andrewparlane/fiuba6661_microelectronica_tpfinal/informe/6661_andrewp_TP_Final_v1_comentarios_mariano.pdf

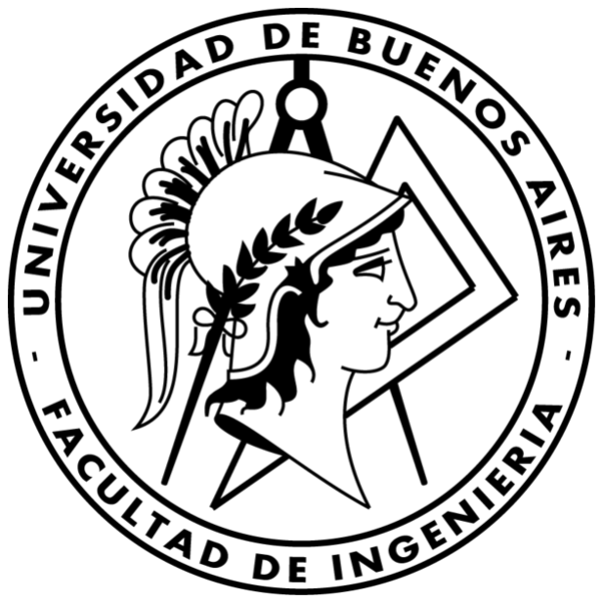
[picture p29: figure]

### 66.61 - Tecnología de Circuitos Integrados Trabajo Práctico Final Sintetizador de Frecuencias para un Microcontrolador con un PLL Digital

### Andrew Parlane

### 30 de marzo de 2019

1

Comentarios generales:
- mover las figuras cerca del lugar del texto dónde son mencionadas (es muy incómodo tener que adelantar páginas para ver las figuras)
- corregir los errores del texto
- Agregar las secciones de introducción y conclusiones

## Índice

1. Objetivo | 3
2. TSMC 180 | 3
3. Compuertas básicos | 3
4. VCO | 4
5. Divisor de Frecuencias | 7
6. PFD y el Filtro de Lazo | 10
7. PLLD y Sintetizador de Frecuencias | 11

## Índice de figuras

1. | Esquemático de dos inversores cascadas | | 3
2. | Simulación para encontrar el mejor ratio entre WN Y WP | | 4
3. | Una selección de compuertas | | 5
4. | Un Oscilador en Anillo limitado por corriente | | 5
5. | Fuente de corriente controlado por tensión | | 6
6. | Simulación de la fuente de corriente controlado por tensión | | 6
7. | Esquemático del VCO | | 7
8. | Esquemático de la prueba para VCO | | 7
9. | Simulación de Frecuencia medida y estimada contra WN | | 8
10. Simulación de Frecuencia medida y estimada contra VIN | | 8
11. Implementación de un divisor de frecuencias de 2N | | | 9
12. Prueba para el divisor de frecuencias de 2N | | 9
13. Divisor de frecuencias de 2N | | 9
14. Divisor de frecuencias de 2N con otro comparrador | | 10
15. Comparación entre los dos divisores de 2N | | 10
16. Un PFD básico | | 11
17. Simulación del PFD básico | | 11
18. Otro diseño de un PFD | | 12
19. Simulación del otro PFD | | 12
20. Salida de tri-state | | 13
21. Filtro de Lazo para usar con el PFD con salida tri-state | | 13
22. Esquemático del PLLD entero | | 14
23. Simulación de un PLLD con reloj de entrada de 25 MHz y salida 200 MHz | | 15
24. Simulación de un PLLD con reloj de entrada de 12 MHz y salida 264 MHz | | 15
25. Simulación de un PLLD con reloj de entrada de 100 MHz y salida 200 MHz. . . . | 16
26. Simulación de un PLLD con reloj de entrada de 5 MHz y salida 150 MHz | | 16
27. Esquemático de un sintetizador de frecuencias | | 16
28. Simulación de un sintetizador de frecuencias con reloj de entrada de 100 MHz y
salida 150 MHz | 17

2

## 1. Objetivo

El objetivo de este trabajo es diseñar un sintetizador de frecuencias para uso en un microcontrolador con un PLL digital. Debería tomar un reloj de entrada con frecuencia fref y unas señales de control y producir un reloj de salida con frecuencia fo = Nfref /M, donde N y M depende en las señales de control.

## 2. TSMC 180

Para comenzar tuve que aprender un poco sobre la tecnologia de TSMC 180. Leyendo los documentos dados encontré:
Parámetro | Valor
LM IN | 0.18 µm
WM IN | 0.42 µm
LDM IN | 0.48 µm
VDDMAX | 1.8 V
No pude encontrar una lista de capacitancias entre cada capa, pero en el spice.lib encontré tOX = 4.1 nm, con esto pude calcular COX = 8418 aF/µm².
Realicé una simulación para encontrar el mejor ratio entre WN y WP . Figura 1 muestra el esquemático y Figura 2 muestra el resultado. El mejor tiempo de propagación es dado cuando WP = 1,5WN . Así en este proyecto uso WPFACT = 1.5.

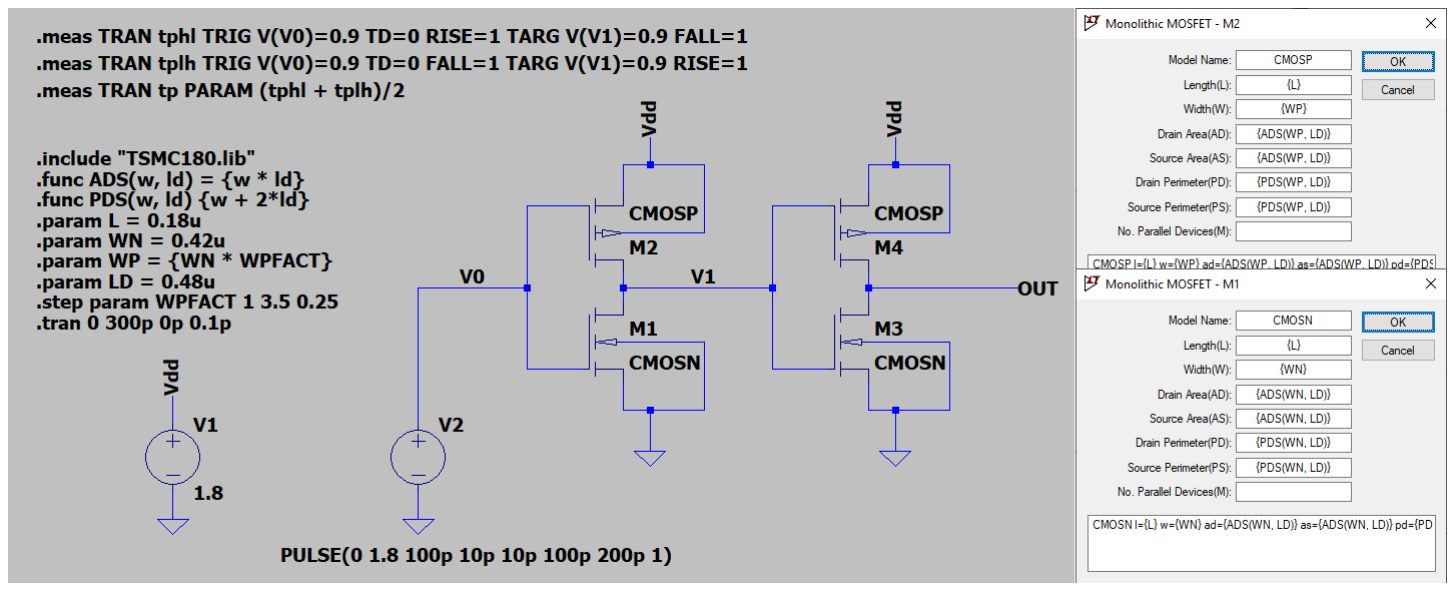
[picture p30: figure]

Figura 1: Esquemático de dos inversores cascadas.

## 3. Compuertas básicos

Implementé varias compuertas básicos y realicé simulaciones para verificar su comportamien-to. Los componentes que diseñe son:

AND con 2, 3 y 4 entradas.
FFD con reset asincróno.
Inversor con el drain conectado a VDD y el source conectado a tierra. Inversor con el drain y el source exportado en el netlist.
MUX con 2 vias.
MUX con 4 vias y salida invertido.
NAND con 2, 3 y 4 entradas.

3

Agregar una sección de "Introducción" al PLL propuesto con un diagrama en bloques y una explicación general de su funcionamiento y las señales involucradas.

en --

a

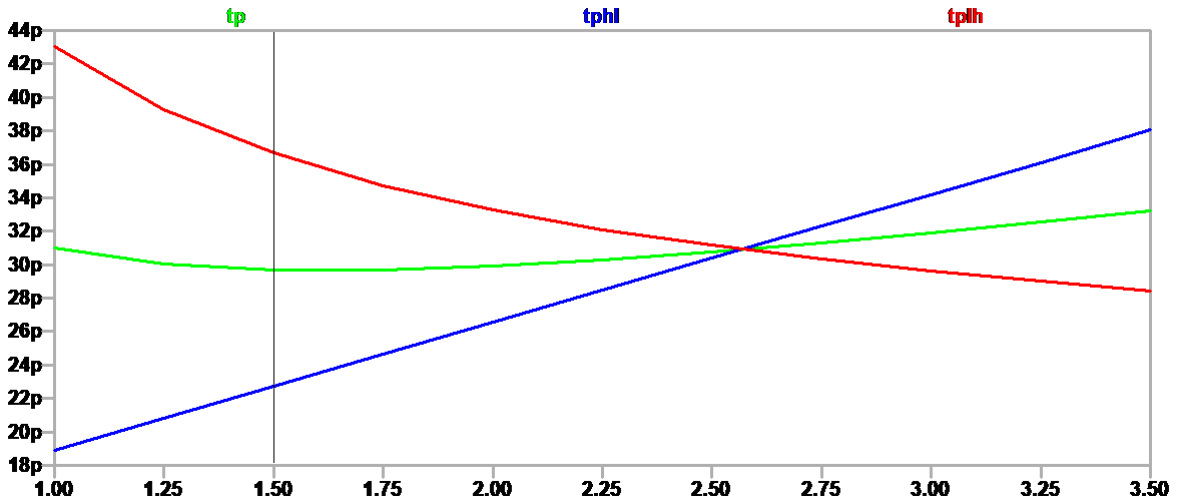
[picture p31: figure]

Figura 2: Simulación para encontrar el mejor ratio entre WN Y WP

NOR con 2 entradas.
OR con 2 entradas.
Transmission Gate.
XNOR con 2 entradas.
XOR con 2 entradas.

No he usado todos en mi diseño final. Cada compuerta consiste de un .asc y un .asy, y es parametrizado así que cada instancia puede usar tamaños diferentes. Figura 3 muestra una selección de las compuertas.

## 4. VCO

Hay varias formas construir un VCO (por Voltage Controlled Oscillator), elegí usar un oscilador en anillo limitado por corriente. Figura 4 muestra la idea. Funciona cómo un oscilador en anillo normal pero los fuentes de corrientes controlan el tiempo de propagación del inversor, cambiando la frecuencia de operación:

Ctot = 5
2

COX(WN LN + WP LP )

f = ID NCtotVDD

Donde N es el número de inversores en el anillo, y WN , LN , WP , LP son los anchos y largos de los transistores en los inversores. Elegí una corriente central de 10 µA que me da por inversores mínimos, y N = 7:

| Ctot = 4.0 fF f = 198.4 MHz

El primer parte estuvo diseñar una fuente de corriente controlado por tensión. Figura 5 muestra el diseño que usé.

4

Dejar en la lista solo las que se hayan usado en este proyecto.

consistió en | La

------------ utilizado.

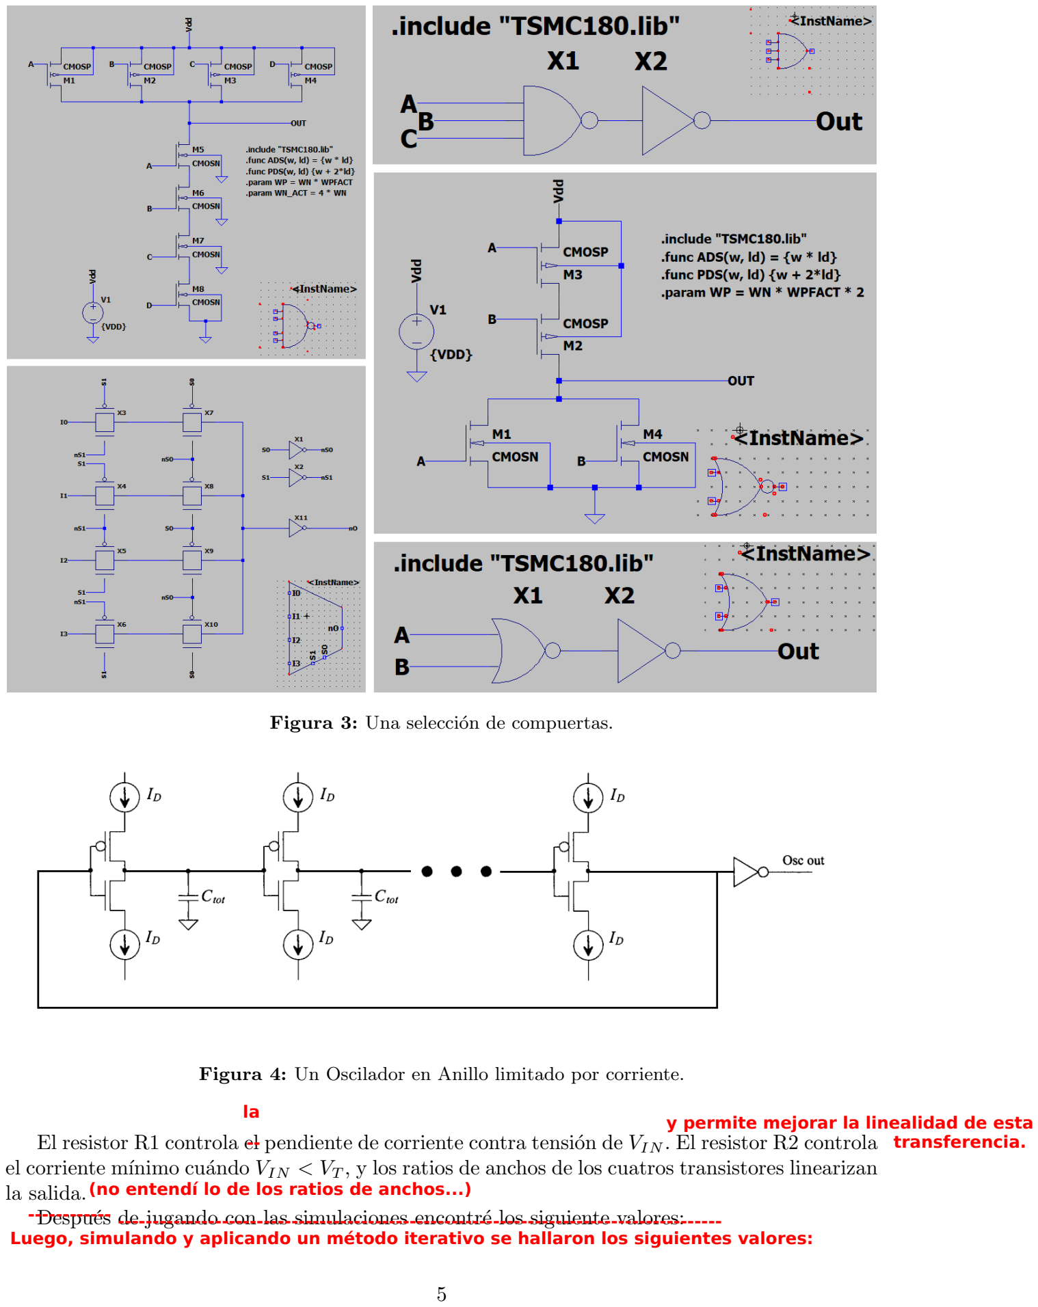
[picture p32: page 5]

Figura 3: Una selección de compuertas.

Figura 4: Un Oscilador en Anillo limitado por corriente.

El resistor R1 controla el pendiente de corriente contra tensión de VIN . El resistor R2 controla el corriente mínimo cuándo VIN < VT , y los ratios de anchos de los cuatros transistores linearizan la salida.
Después de jugando con las simulaciones encontré los siguiente valores:

5

la | y permite mejorar la linealidad de esta transferencia.

(no entendí lo de los ratios de anchos...) --------------------------------------------------------------------------------------- ------------
Luego, simulando y aplicando un método iterativo se hallaron los siguientes valores:


Figura 5: Fuente de corriente controlado por tensión.

L = 0.9 µm
WN = 4.0 µm
W P F ACT = 1,5
W IDEF ACT = 3
R1 = 20.0 kΩ
R2 = 86.0 kΩ

Que me da la salida mostrado en figura 6. Un corriente mínimo de 5.0 µA, un corriente central de 9.9 µA, y un corriente máximo de 20.4 µA. El pendiente es bastante lineal por VIN > 0.7 V, cómo mostrado con la línea azul, con una ecuación de ID = 11.5 µA/VVIN − 0.5 µA.

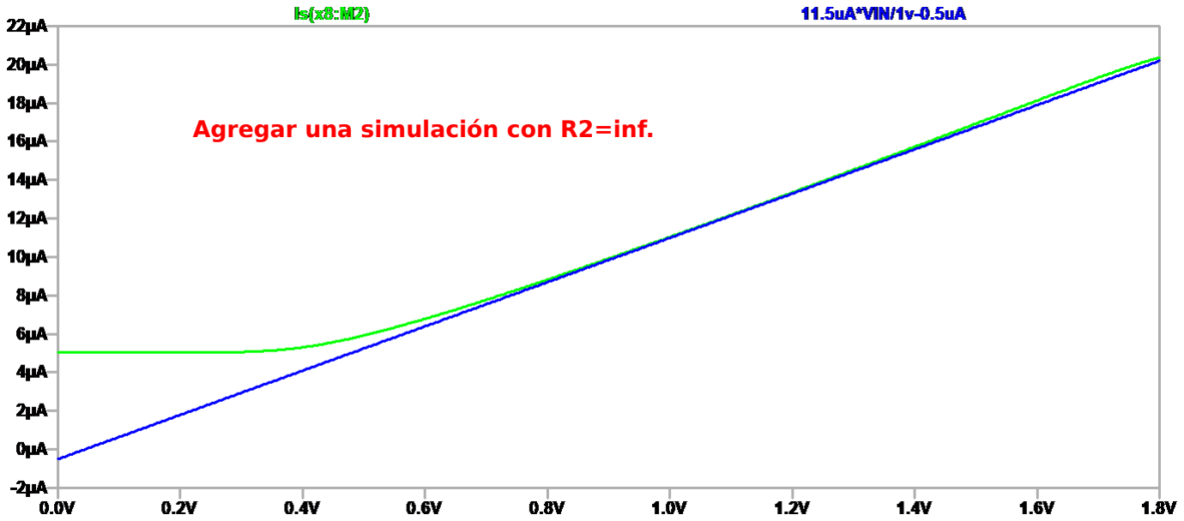
[picture p33: figure]
Agregar una simulación con R2=inf.

Figura 6: Simulación de la fuente de corriente controlado por tensión.

Figura 7 muestra el esquemático del VCO, y Figura 8 muestra el esquemático de prueba con todos los parámetros. Uso directivos de SPICE para medir y calcular la frecuencia promedio y el

6

Dar los W de cada transistor

a | a | a
para LA | ----------- aproximadamente

duty cycle sobre 100 ciclos. También calculo la frecuencia de salida esperado usando las ecuaciones anteriores. Encontré que la práctica y la teoría están bastante diferentes para inversores mínimos, así realicé otras simulaciones para ver cómo cambiando WN afecta estos valores. Figura 9 muestra el resultado. La frecuencia calculada y medida están iguales por WN = 0.52 µm y VIN = 0.9 V. Intenté usar este valor pero la simulación estuvo dando me resultados raros por VIN < 0.5 V, así estoy usando WN = 0.57 µm.

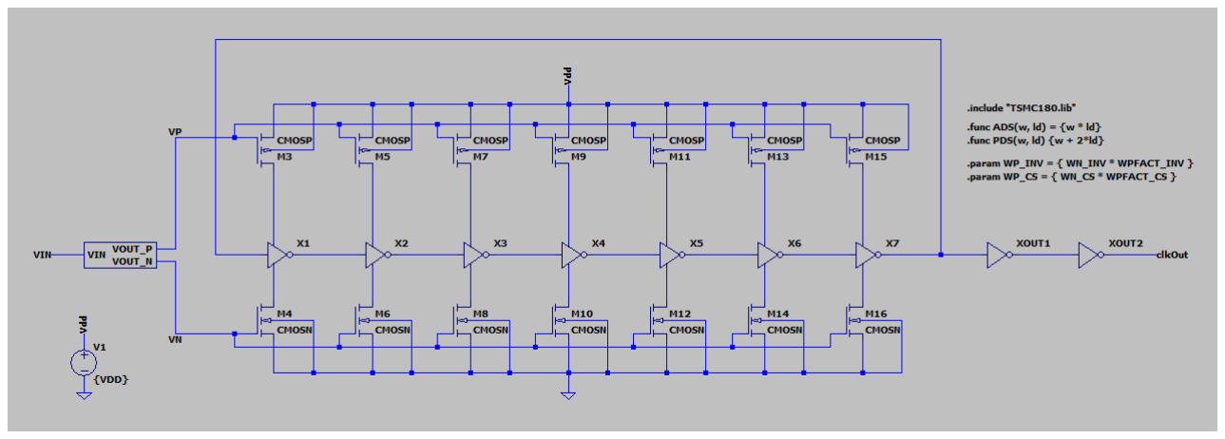
[picture p34: figure]

Figura 7: Esquemático del VCO.

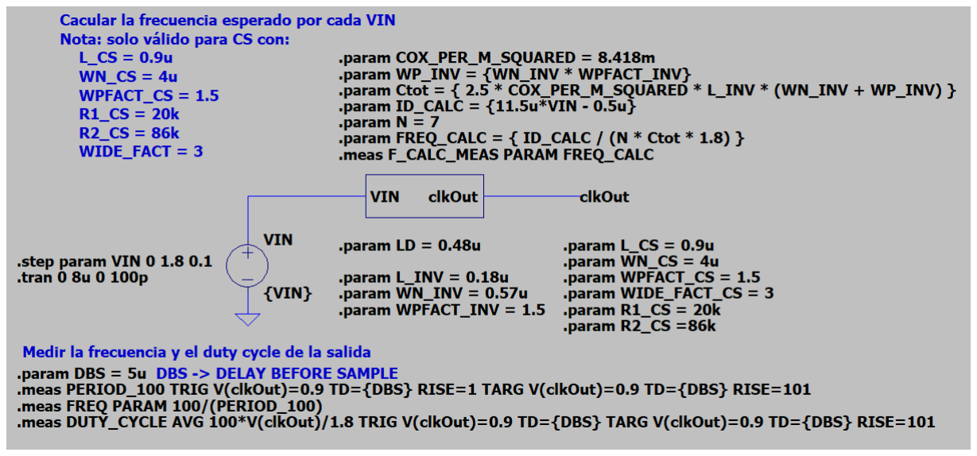
[picture p35: figure]

Figura 8: Esquemático de la prueba para VCO.

Figura 10 muestra cómo cambia la frecuencia medido y estimado con VIN . No están iguales pero están bastante cerca. El pendiente del parte lineal es aproximadamente 200 MHz/V dando un KV CO = 2π · 200 MHz/V = 1.26 × 10⁹ rad/(V s).

## 5. Divisor de Frecuencias

Hay varias arquitecturas para implementar divisores de frecuencias, cual es mejor depende en la especificación del proyecto. Para este trabajo quise dividir por un valor programable.
Al principio implemente un divisor de frecuencias que puede dividir por 2N . La implementación es N FFDs en cascada cómo muestra Figura 11. Cada ciclo del clkIn hace que div2 invierte

7

a
------- son

(no entendí la última oración)

simulada ------------

la calculada ---------------------

------------------------------------ LA Se observa que ambas curvas son similares para Vin entre ...V y ...V.

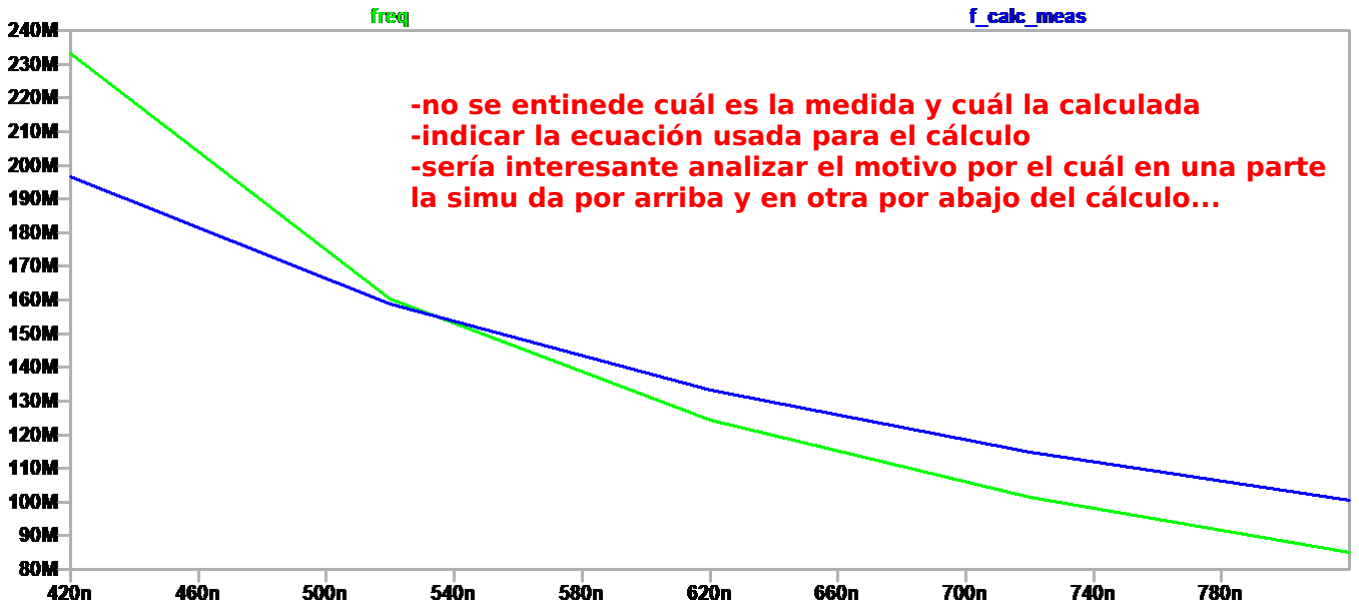
[picture p36: figure]

Figura 9: Simulación de Frecuencia medida y estimada contra WN .

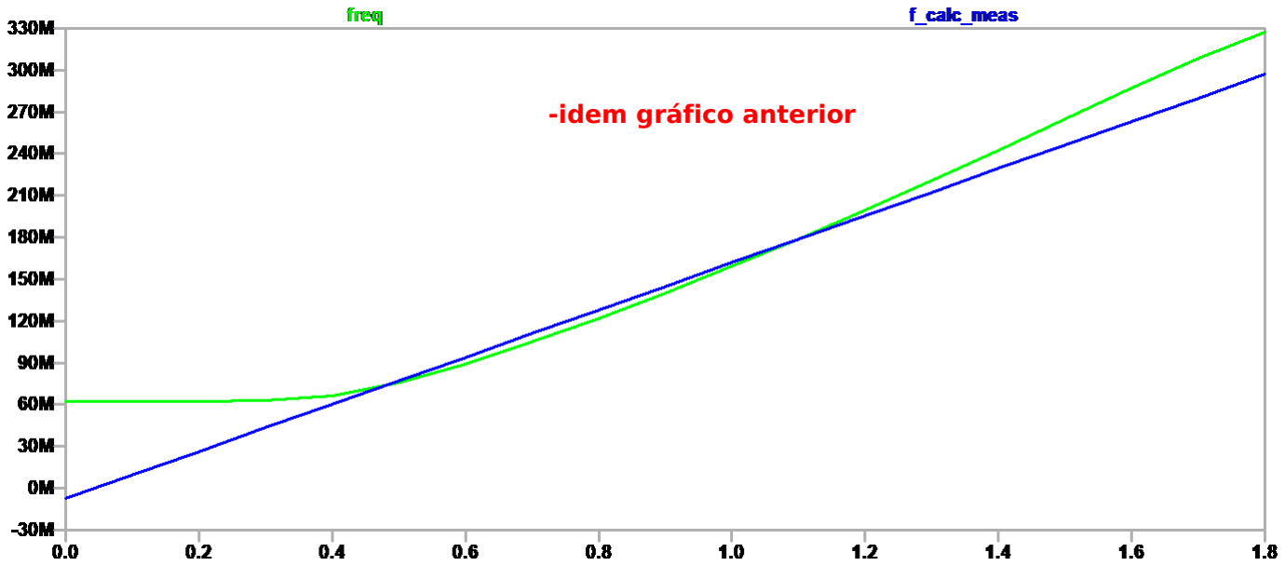
[picture p37: figure]
-idem gráfico anterior

Figura 10: Simulación de Frecuencia medida y estimada contra VIN .

su valor, así div2 completa un ciclo cada dos ciclos de/ clkIn. Después div4 completa un ciclo cada dos ciclos de/ div2, o cuatro ciclos del clkIn, etc... Mi implementación solo permite dividir hasta 16, para dividir por factores más altos puede conectar dos de los componentes en cascada. Un MUX puede ser usado para elegir la salida querido, como muestra Figura 12.
El problema con esta arquitectura es que cuando está usado en el PLLD, solo se permite obtener uno o dos frecuencias válidos. Por ejemplo con el VCO descripto en la sección anterior, la salida del VCO tiene que ser entre 60 MHz y 330 MHz. Por un reloj de entrada de 12 MHz solo podríamos usar un divisor de 8 para obtener 96 MHz o de 16 para obtener 192 MHz. Un divisor de 4 da una salida de 48 MHz y un divisor de 32 da una salida de 384 MHz, ambos de los dos están afuera del rango de la operación del VCO.
Un divisor que puede producir un rango lineal de salidas nos da más opciones. Así implementé un componente que divide por 2N. Figura 13 muestra una implementación. De nuevo usa una cadena de FFDs, pero este vez se usa como un contador digital. Unas compuertas XNOR hacen

8

-no se entinede cuál es la medida y cuál la calculada -indicar la ecuación usada para el cálculo
-sería interesante analizar el motivo por el cuál en una parte la simu da por arriba y en otra por abajo del cálculo...
a | a

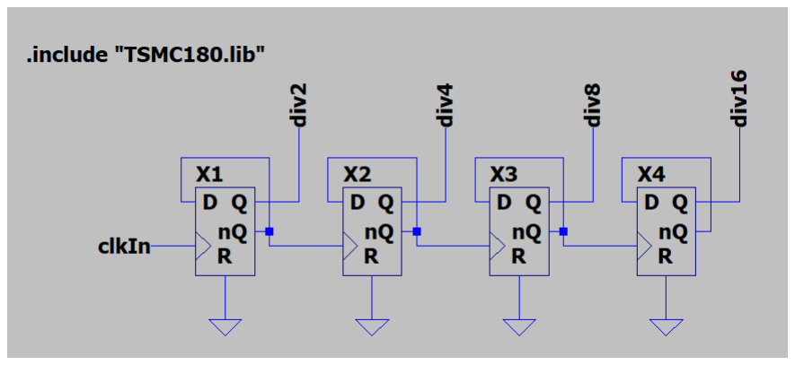
[picture p38: figure]

Figura 11: Implementación de un divisor de frecuencias de 2N

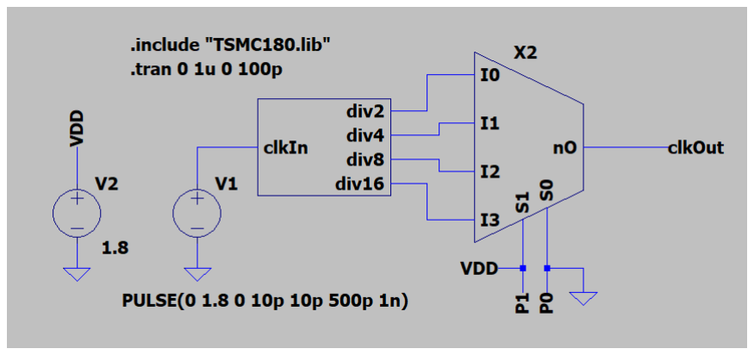
[picture p39: figure]

Figura 12: Prueba para el divisor de frecuencias de 2N

una comparación entre el valor del contador Q y el factor de división querido P. Cuando todos los bits están iguales invierte el clkOut. También implementé un otro divisor, mostrado en Figura 14, que es muy parecido. La única diferencia es el comparador. Figura 15 muestra una simulación comparando los dos. El primer diseño (con las compuertas XNOR) es aproximadamente 270 ps más rápido que el segundo, así elegí usar eso. Los dos diseños no funcionan cuando P = 0 y dan una salida con frecuencia fout = fin/2P por los demás valores de P.

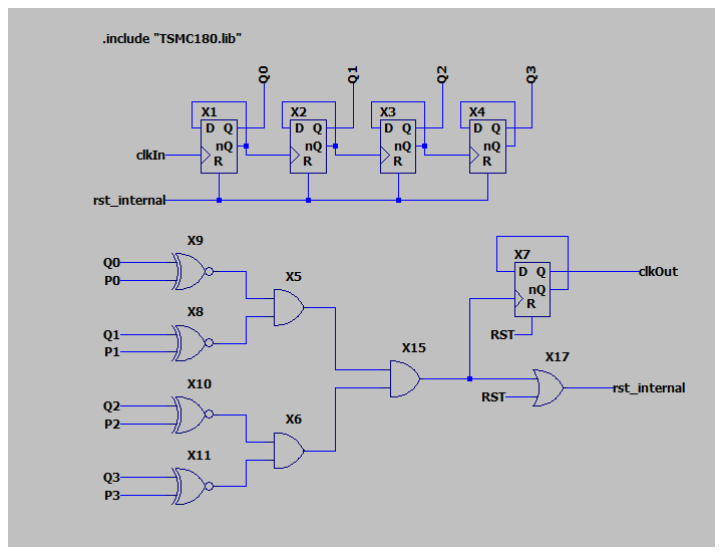
[picture p40: figure]

Figura 13: Divisor de frecuencias de 2N.

9

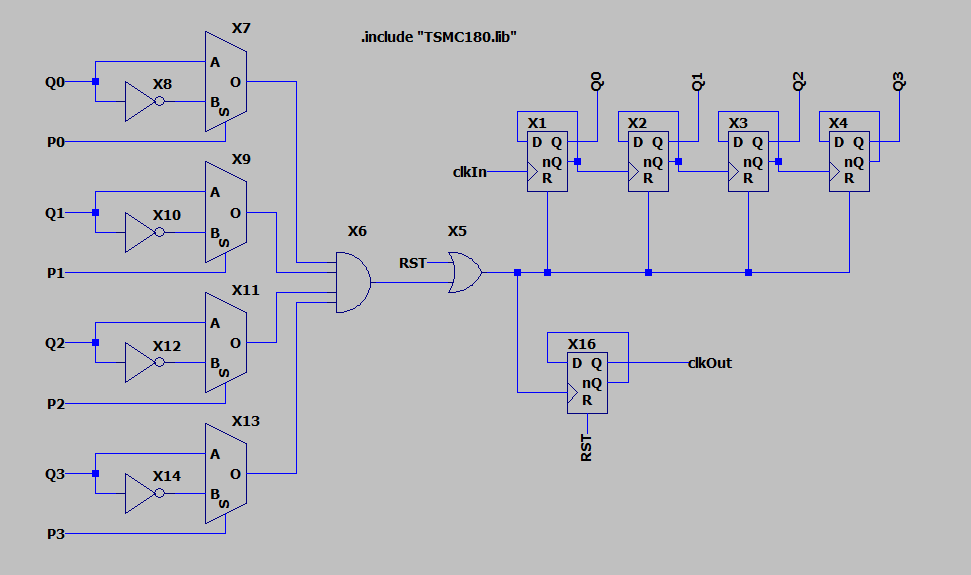
[picture p41: figure]

Figura 14: Divisor de frecuencias de 2N con otro comparrador.

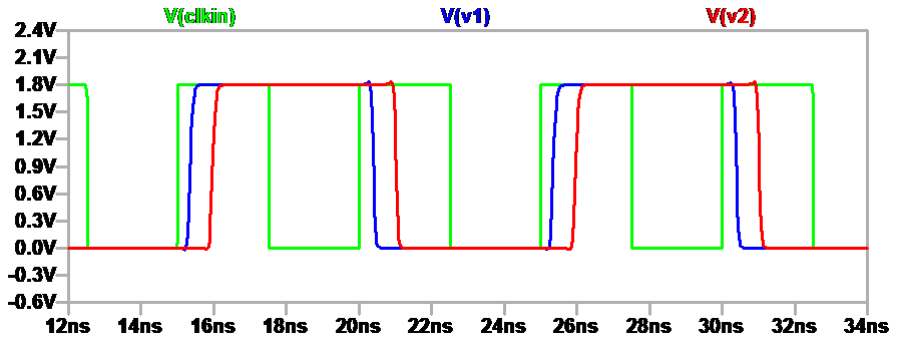
[picture p42: figure]

Figura 15: Comparación entre los dos divisores de 2N.

Con este divisor de frecuencias, el VCO de la sección anterior y un reloj de entrada de 12 MHz, podríamos producir 11 salidas con frecuencias entre 72 MHz y 312 MHz.

## 6. PFD y el Filtro de Lazo

El PFD (por Phase Frequency Detector) es un componente que toma dos señales y indique la diferencia entre sus fases. Figura 16 muestra una implementación de un PFD. En el primer flanco ascendente de dClock o clkIn la salida de su FFD cambia a un uno. Cuando llega el flanco del otro señal, la salida de su FFD cambia a un uno también, así la salida de la compuerta AND cambia a un uno y pone a cero los dos FFDs. Así la salida UP o DOWN es alto por el tiempo entre los flancos ascendentes de los relojes. Estos dos señales pueden ser combinados en uno para indicar la diferencia en fase. Usando directivos de SPICE medí el tiempo que las señales UP y DOWN estuvieron alto por cada offset entre los relojes entre −800 ps y 800 ps en intervales de 10 ps, figura 17 muestra estas mediciones.
Figura 18 muestra un otro diseño de un PFD, y Figura 19 muestra el ancho de los señales UP y DOWN. En este diseño hay un pequeño “dead zone” cuándo ninguno de los señales UP y DOWN están altos, pero en el diseño básico hay una superposición de aproximadamente 280 ps cuándo los dos señales están altos.
Para juntar UP y DOWN uso una salida de tri-state, Figura 20 muestra el esquemático. Cuando UP o DOWN están altos, la carga sobre los drains puede cargar o descargar, pero

10

e | -----ca
a | a
a | ------- simulé

------------------------ los resultados.

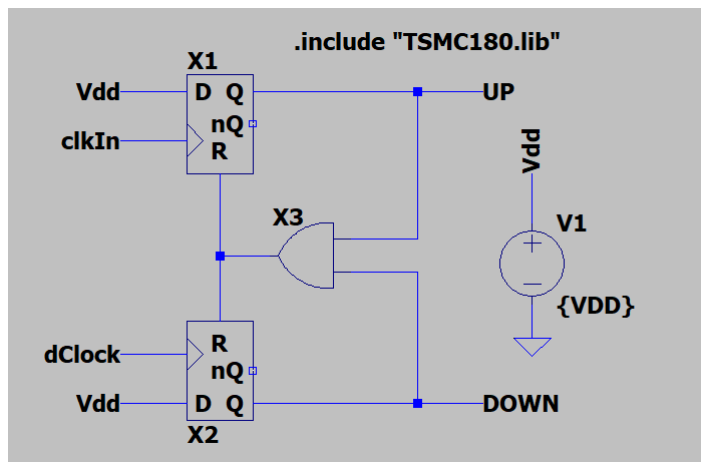
[picture p43: figure]

Figura 16: Un PFD básico.

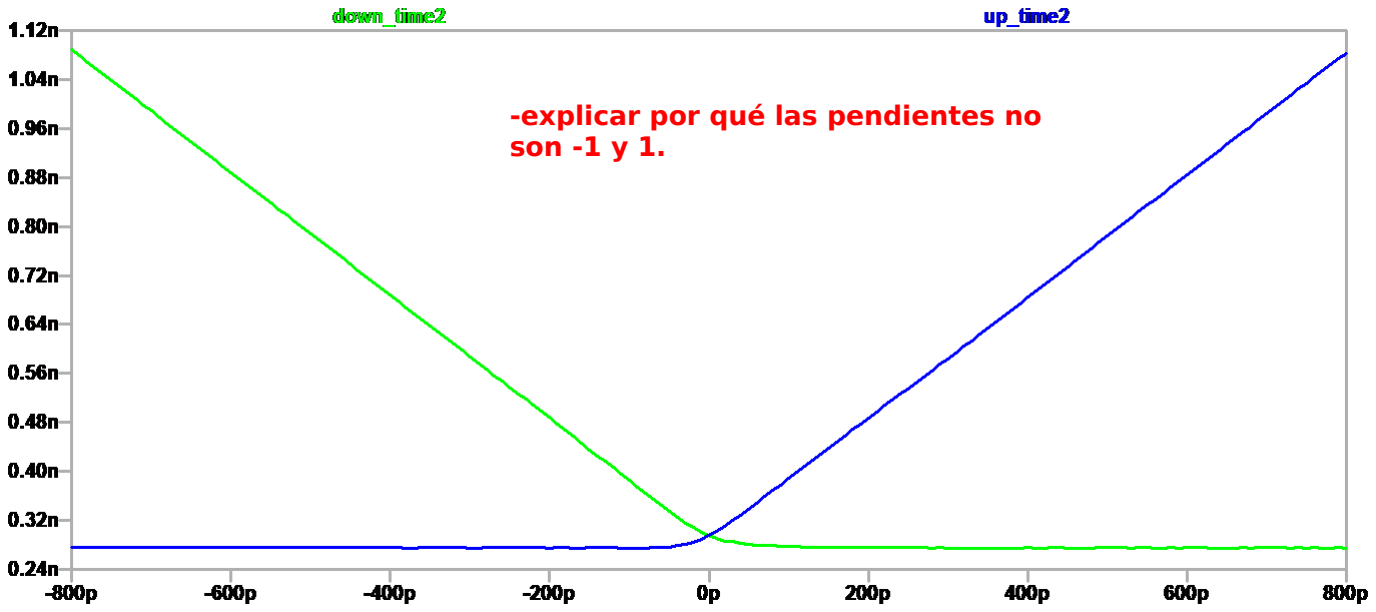
[picture p44: figure]
-explicar por qué las pendientes no son -1 y 1.

Figura 17: Simulación del PFD básico.

cuando ninguno de los señales están altos, la salida tiene alta impedancia. El gain del PFD con la salida tri-state es KPDtri = VDD/4π.
Finalmente es necesario pasar la salida del PFD por un filtro. El filtro usado es mostrado en Figura 21. La función de transferencia del filtro de lazo es: KF = 1+sR2C
s(R1+R2)C .

## 7. PLLD y Sintetizador de Frecuencias

Figura 22 muestra el esquemático final con todos los componentes conectados. Las ecuaciones para este PLL son:

11

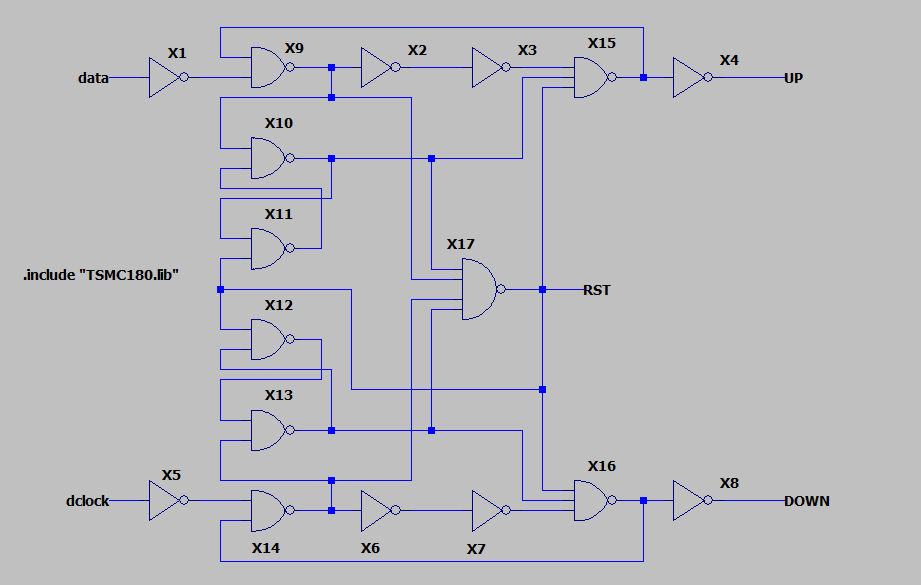
[picture p45: figure]

Figura 18: Otro diseño de un PFD.

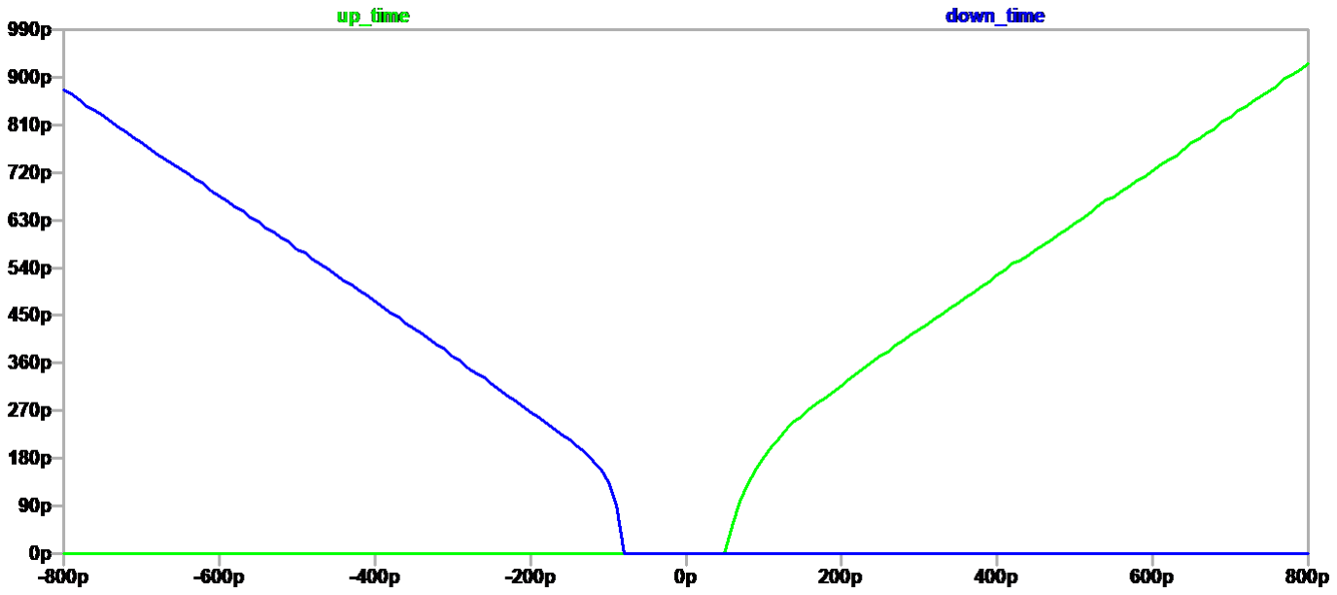
[picture p46: figure]

Figura 19: Simulación del otro PFD.

H(s) = KPDtriKF KV CO s + 1 N KPDtriKF KV CO

ωn =

| KPDtriKV CO N(R1 + R2)C
ζ = ωn | 2 R2C

ΔωL = 4πζωn
ΔωP = π
2
| 2ζωnKV COKPDtri − ω²

n

Donde:

| 12

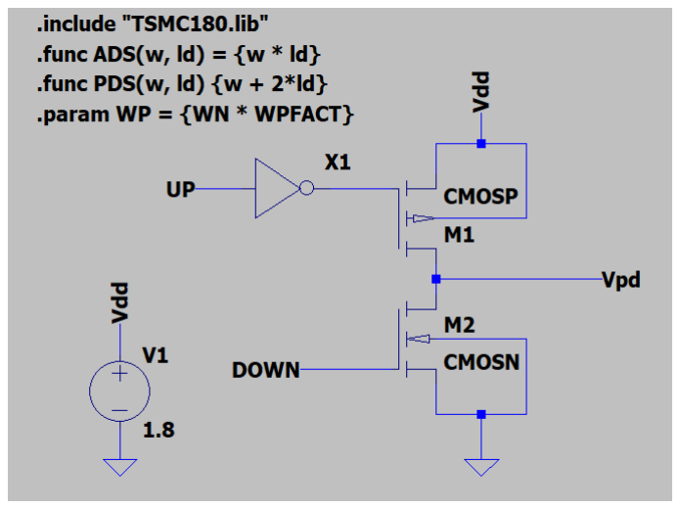
[picture p47: figure]

Figura 20: Salida de tri-state.

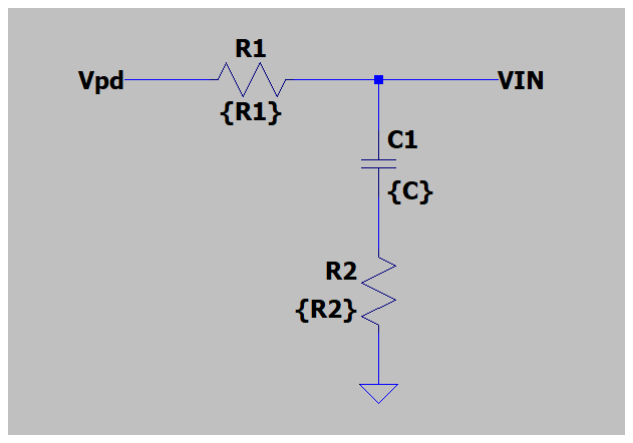
[picture p48: figure]

Figura 21: Filtro de Lazo para usar con el PFD con salida tri-state.

H(s) = La función de transferencia de fase. ωn = La frecuencia natural.
ζ = El factor de amortiguamiento.
ΔωL = El rango de lock.
N = El factor de división.
ΔωP = El rango de pull-in.

Comenzando con ζ = 1, ΔωL = 20 MHz · 2π y N = 8. Encontramos ωn = 10 × 10⁶ rad/s y R2C = 200 ns. Eligiendo C = 10 pF y R2 = 20 kΩ, podríamos encontrar R1 = 2.56 kΩ. Porque queremos tener N programable podríamos volver calcular ωn, ζ, ΔωL, y ωP por cada N entre 2 y 30.

13

Mostrar acá el circuito circuito final utilizado para el PLLD.

N | ωn (rad/s) | ζ | ωL (rad/s) | FL (MHz) | Wp (rad/s) | Fp (MHz)
2 4 6 8 10 12 14 16 18 20 22 24 26 28 30 | 20.00 × 10⁶ 14.14 × 10⁶ 11.55 × 10⁶ 10.00 × 10⁶ 8.94 × 10⁶ 8.16 × 10⁶ 7.56 × 10⁶ 7.07 × 10⁶ 6.67 × 10⁶ 6.32 × 10⁶ 6.03 × 10⁶ 5.77 × 10⁶ 5.55 × 10⁶ 5.35 × 10⁶ 5.16 × 10⁶ | 2.0 1.4 1.2 1.0 0.9 0.8 0.8 0.7 0.7 0.6 0.6 0.6 0.6 0.5 0.5 | 503 × 10⁶ 251 × 10⁶ 168 × 10⁶ 126 × 10⁶ 101 × 10⁶ 84 × 10⁶ 72 × 10⁶ 63 × 10⁶ 56 × 10⁶ 50 × 10⁶ 46 × 10⁶ 42 × 10⁶ 39 × 10⁶ 36 × 10⁶ 34 × 10⁶ | 80 40 27 20 16 13 11 10 9 8 7 7 6 6 5 | 521 × 10⁶ 401 × 10⁶ 321 × 10⁶ 270 × 10⁶ 235 × 10⁶ 209 × 10⁶ 189 × 10⁶ 173 × 10⁶ 160 × 10⁶ 149 × 10⁶ 139 × 10⁶ 131 × 10⁶ 124 × 10⁶ 118 × 10⁶ 112 × 10⁶ | 83 64 51 43 37 33 30 27 25 24 22 21 20 19 18

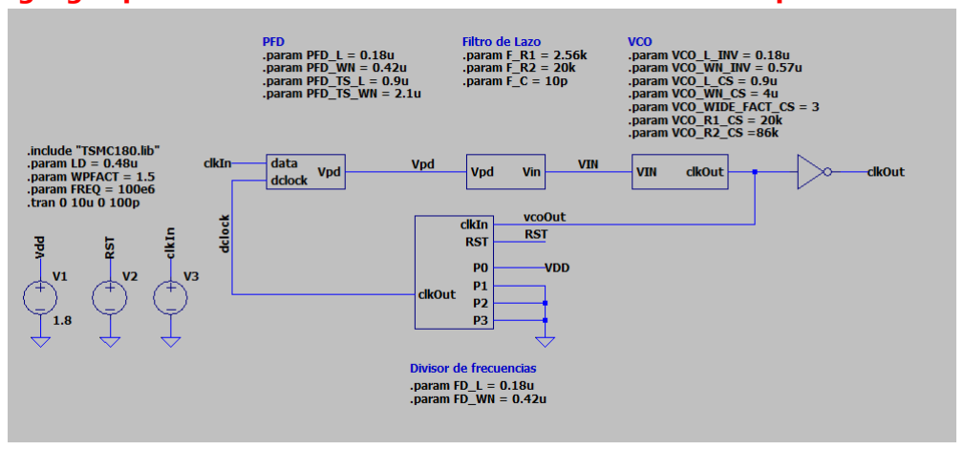
[picture p49: figure]

Figura 22: Esquemático del PLLD entero.

Figuras 23, 24, 25 y 26 muestran varias simulaciones del PLLD entero con diferentes frecuencias de entrada entre 5 MHz y 100 MHz y diferentes factores de multiplicación entre 2 y 30. Figura 27 muestra el esquemático de un sintetizador de frecuencias que connsiste en un PLLD, un prescaler y un postscaler. Figurar 28 muestra una simulación del sintetizador de frecuencias para obtener un reloj de 150 MHz desde un reloj de entrada de 100 MHz.

## Referencias

[1] R. Jacob Baker (2010) CMOS: Circuit design, layout and simulation, Wiley-IEEE Press, 3rd edition.
[2] Suman, Shruti & G Sharma, K & Ghosh, Pradip. (2016). Analysis and Design of Current Starved Ring VCO. 10.1109/ICEEOT.2016.7755299.
[3] Rushabh Mehta (2016) Ddesign and Implementation of a phase locked loop for high-speed serial links. University of Illinois. http://emlab.uiuc.edu/jose/Theses/mehta_ms.pdf.
[4] Passive Filters. http://aries.ucsd.edu/najmabadi/CLASS/ECE60L/02-S/NOTES/filter. pdf.

14

Agregar columna Fn.

Pasar referencias al final.

Agregar pie a la tabla: "Tabla 1. dinámica del sistema para diferntes valores de N".

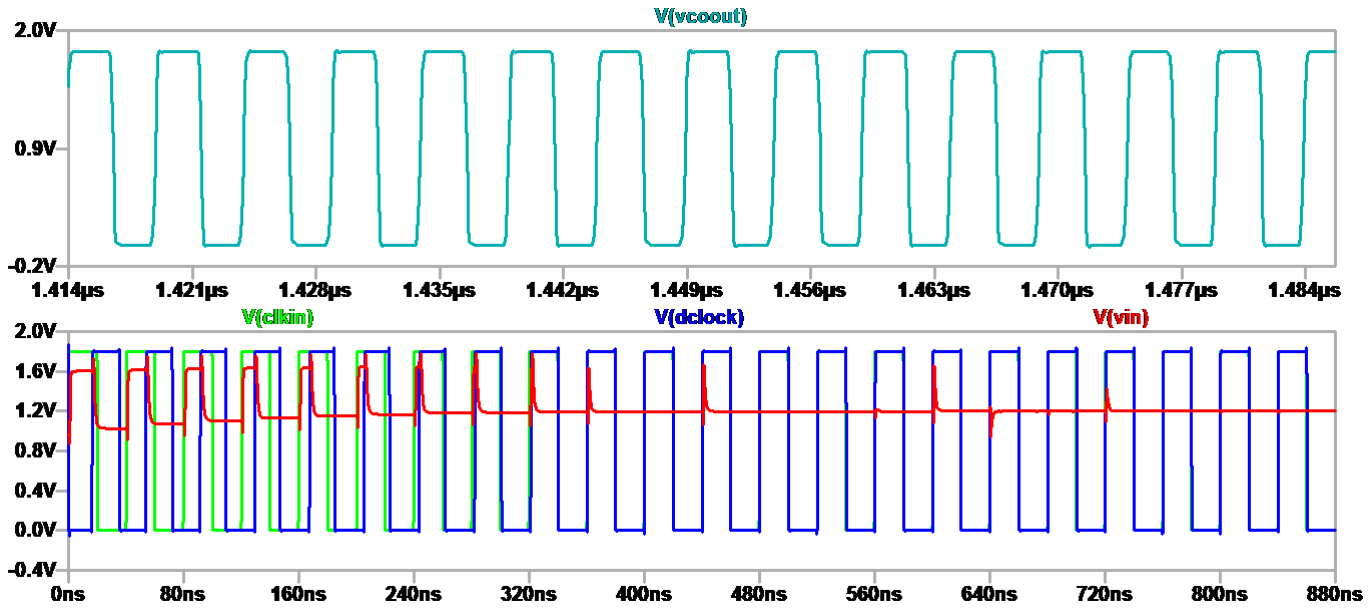
[picture p50: figure]

Figura 23: Simulación de un PLLD con reloj de entrada de 25 MHz y salida 200 MHz.

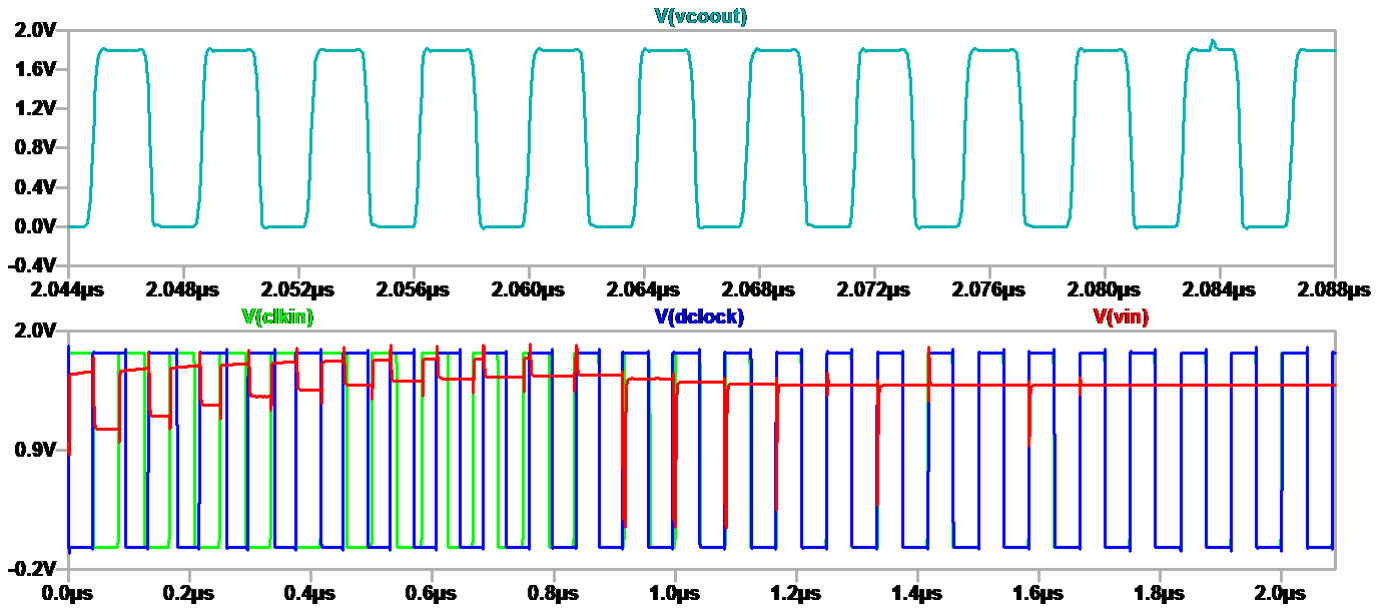
[picture p51: figure]

Figura 24: Simulación de un PLLD con reloj de entrada de 12 MHz y salida 264 MHz.

15

-Especificar para cada una de estas simulaciones el N utilizado.
-Vin es la entrada del VCO, verdad? Explicitar esto en el texto.
-Agregar un párrafo pra cada simulación describiendo el resultado obtenido y si
la dinámica del sistema es la que se espera según la Tabla 1.
-Estas simulaciones son del "encendido" del PLL, verdad? Es decir en t=0 se enciende el sistema.

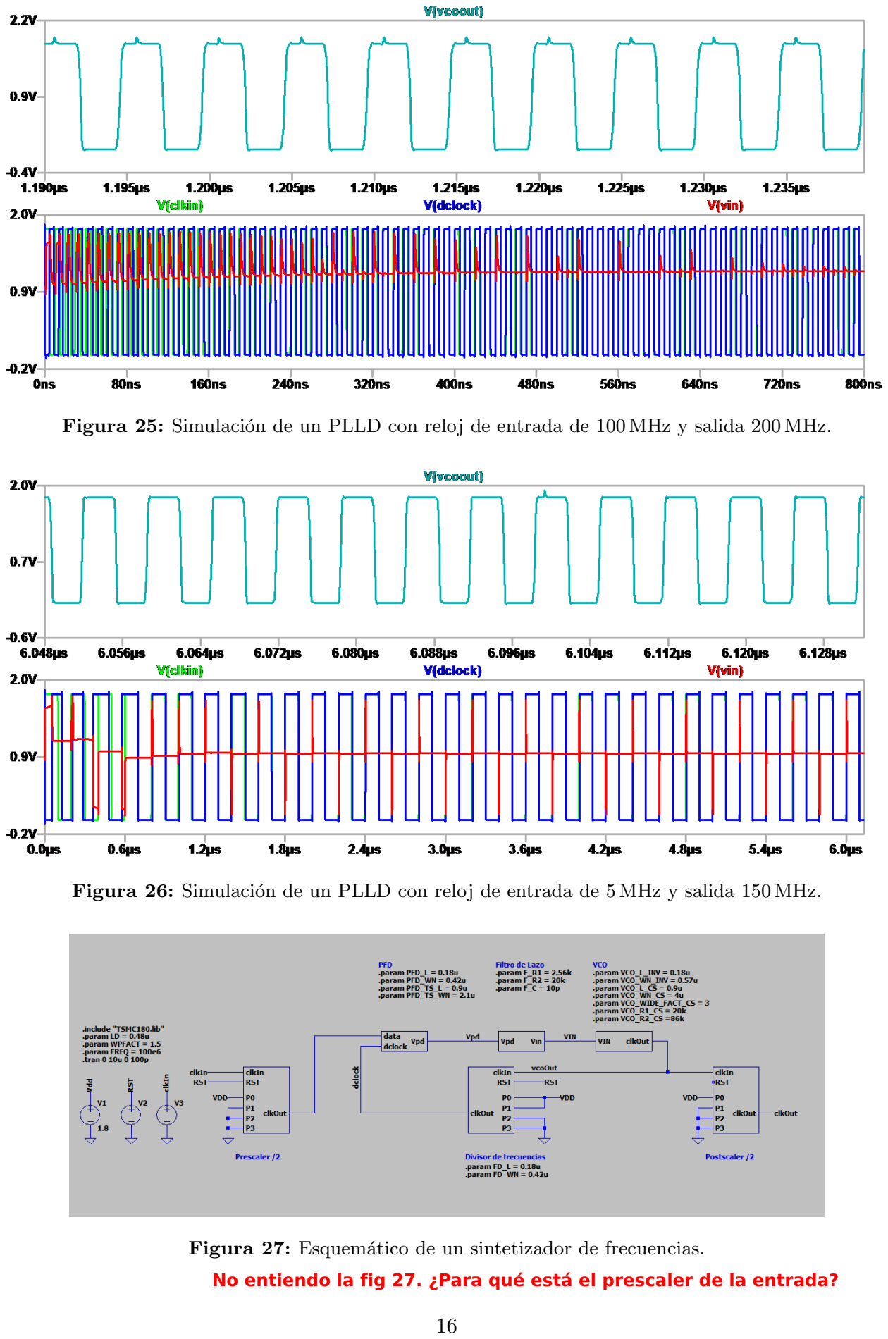
[picture p52: page 16]

Figura 25: Simulación de un PLLD con reloj de entrada de 100 MHz y salida 200 MHz.

Figura 26: Simulación de un PLLD con reloj de entrada de 5 MHz y salida 150 MHz.

Figura 27: Esquemático de un sintetizador de frecuencias.

16

No entiendo la fig 27. ¿Para qué está el prescaler de la entrada?

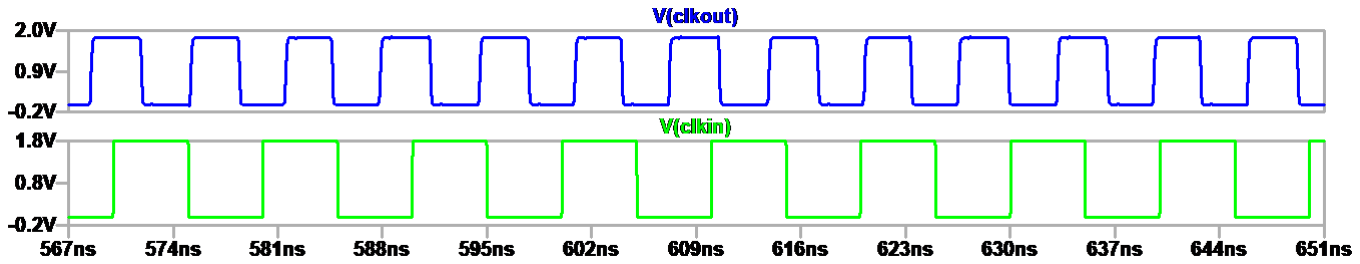
[picture p53: figure]

Figura 28: Simulación de un sintetizador de frecuencias con reloj de entrada de 100 MHz y salida 150 MHz.

17

Agregar sección "conclusiones" y discutir el desempeño obtenido.
Otras preguntas interesantes para comentar son:
-¿Vale la pena utilizar un divisor 2N o un divisor 2^N sería mejor?
-¿Sería conveniente utilizar un banco de capacitores y resistores para modificar el valor del filtro de lazo según el valor que tome N?
