andrewparlane/fiuba6661_microelectronica_tpfinal/informe/6661_andrewp_TP_Final_v2 .pdf

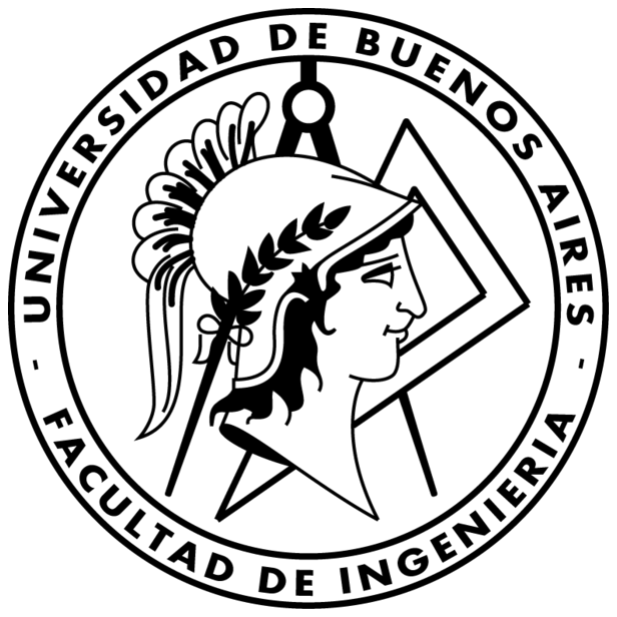
[picture p54: figure]

66.61 - Tecnología de Circuitos Integrados
Trabajo Práctico Final
Sintetizador de Frecuencias para un Microcontrolador con un PLL Digital

Andrew Parlane

4 de julio de 2019

1

## Índice

1. Objetivo | 4
2. Introducción | 4
2.1. Sintetizador de frecuencias | | 4
2.2. PLL Digital | | 4
3. TSMC 180 | 5
4. Compuertas básicos | 6
5. VCO | 7
6. Divisor de Frecuencias | 11
7. PFD y el Filtro de Lazo | 13
8. PLLD | 17
9. Sintetizador de Frecuencias | 19
10.Conclusión | 21

## Índice de figuras

1. | Un diagrama de bloques de un sintetizador de frecuencias | | 4
2. | Un diagrama de bloques de un PLLD | | 5
3. | Esquemático de dos inversores en cascada | | 6
4. | Simulación para encontrar el mejor ratio entre WN Y WP | | 6
5. | Una selección de compuertas | | 7
6. | Un Oscilador en Anillo limitado por corriente | | 7
7. | Fuente de corriente controlado por tensión | | 8
8. | Simulación de la fuente de corriente controlado por tensión | | 9
9. | Esquemático del VCO | | 9
10. Esquemático de la prueba para VCO | | 10
11. Simulación de Frecuencia medida y estimada contra WN | | 10
12. Simulación de Frecuencia medida y estimada contra VIN | | 11
13. Implementación de un divisor de frecuencias de 2N | | | 11
14. Prueba para el divisor de frecuencias de 2N | | | 12
15. Divisor de frecuencias de 2N | | 12
16. Divisor de frecuencias de 2N con otro comparrador | | 13
17. Comparación entre los dos divisores de 2N | | 13
18. Un PFD básico | | 14
19. Simulación del PFD básico | | 14
20. Otro diseño de un PFD | | 15
21. Simulación del otro PFD | | 15
22. Salida de tri-state | | 16
23. Filtro de Lazo para usar con el PFD con salida tri-state | | 16
24. Esquemático del PLLD entero | | 17

2

25. Simulación de un PLLD con reloj de entrada de 25 MHz, N=8 y salida 200 MHz. | 18
26. Simulación de un PLLD con reloj de entrada de 12 MHz, N=22 y salida 264 MHz. | 19
27. Simulación de un PLLD con reloj de entrada de 100 MHz, N=2 y salida 200 MHz. | 19
28. Simulación de un PLLD con reloj de entrada de 5 MHz, N=30 y salida 150 MHz. | 19
29. Esquemático de un sintetizador de frecuencias | | 20
30. Simulación de un sintetizador de frecuencias con reloj de entrada de 100 MHz y
salida 44.44 MHz | 20

3

## 1. Objetivo

El objetivo de este trabajo es diseñar un sintetizador de frecuencias para uso en un microcontrolador con un PLL digital. Debería tomar un reloj de entrada con frecuencia fref y unas señales de control y producir un reloj de salida con frecuencia fo = Nfref /M, donde N y M depende en las señales de control.

## 2. Introducción

### 2.1. Sintetizador de frecuencias

Un PLLD produce un reloj de salida con frecuencia fo desde un reloj de entrada con frecuencia fi con las restricciones:

fimin ≤ fi ≤ fimax

fomin ≤ fo ≤ fomax
fo = Nfi | N ∈ Z

Nmin ≤ N ≤ Nmax

Para obtener un mejor rango de fo se puede dividir la salida del PLL con un divisor de frecuencias. Frecuentemente se usa otro divisor de frecuencias antes del PLL para permitir un rango de fi más grande. Los valores de multiplicación y división pueden ser constantes o programables. Figura 1 muestra un sintetizador de frecuencias típico.

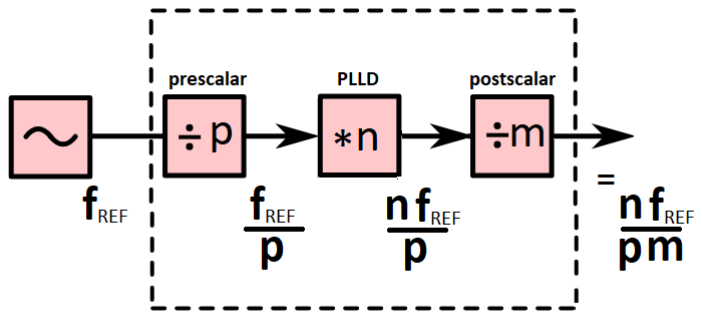
[picture p55: figure]

Figura 1: Un diagrama de bloques de un sintetizador de frecuencias

### 2.2. PLL Digital

Un PLLD consista en cuatro partes:

Un detector de fase que compara dos señales de entrada y genera una señal que representa la diferencia entre las fases.

4

Un filtro de laso que ayuda el PLL estar estable.

Un VCO (por Voltage Controlled Oscillator) que usa una tensión de entrada para cambiar la frecuencia de salida.

Un divisor de frecuencias. La señal de salida vuelva al detector de fase como una de las entradas.

En esta forma el PLL ajuste la salida hasta un múltiple de la entrada. Figura 2 muestra un PLLD en bloques.

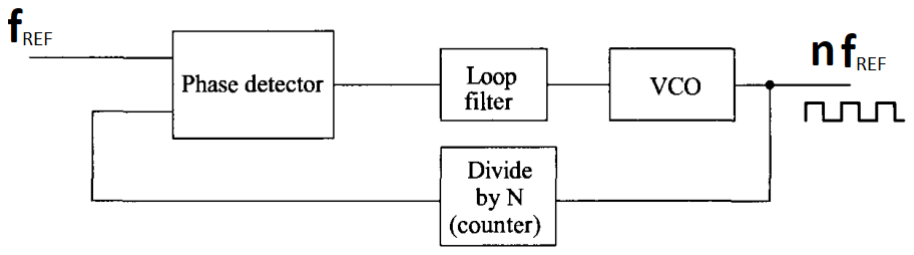
[picture p56: figure]

Figura 2: Un diagrama de bloques de un PLLD

## 3. TSMC 180

Para comenzar tuve que aprender un poco sobre la tecnologia de TSMC 180. Leyendo los documentos dados encontré:
Parámetro | Valor
LM IN | 0.18 µm
WM IN | 0.42 µm
LDM IN | 0.48 µm
VDDMAX | 1.8 V
No pude encontrar una lista de capacitancias entre cada capa, pero en el spice.lib encontré tOX = 4.1 nm, con esto pude calcular C0OX = 8418 aF/µm²
Realicé una simulación para encontrar el mejor ratio entre WN y WP . Figura 3 muestra el esquemático y Figura 4 muestra el resultado. El mejor tiempo de propagación es dado cuando WP = 1,5WN . Así en este proyecto uso W P F ACT = 1,5.

5

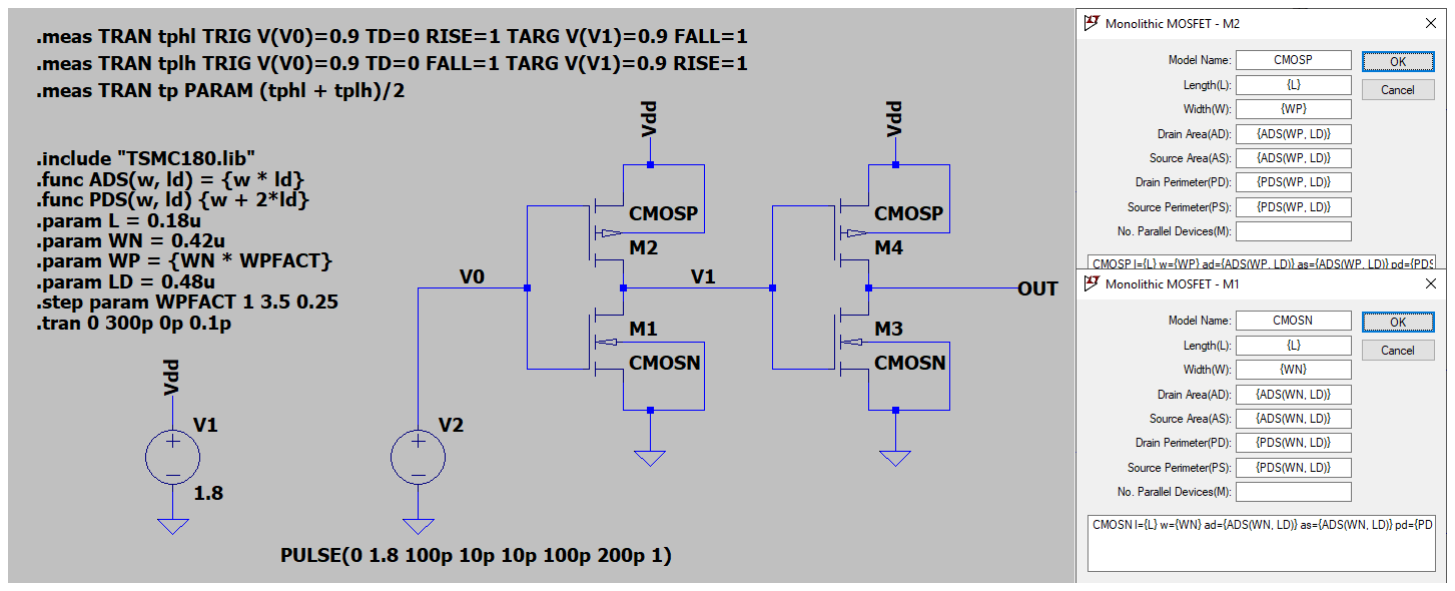
[picture p57: figure]

Figura 3: Esquemático de dos inversores en cascada

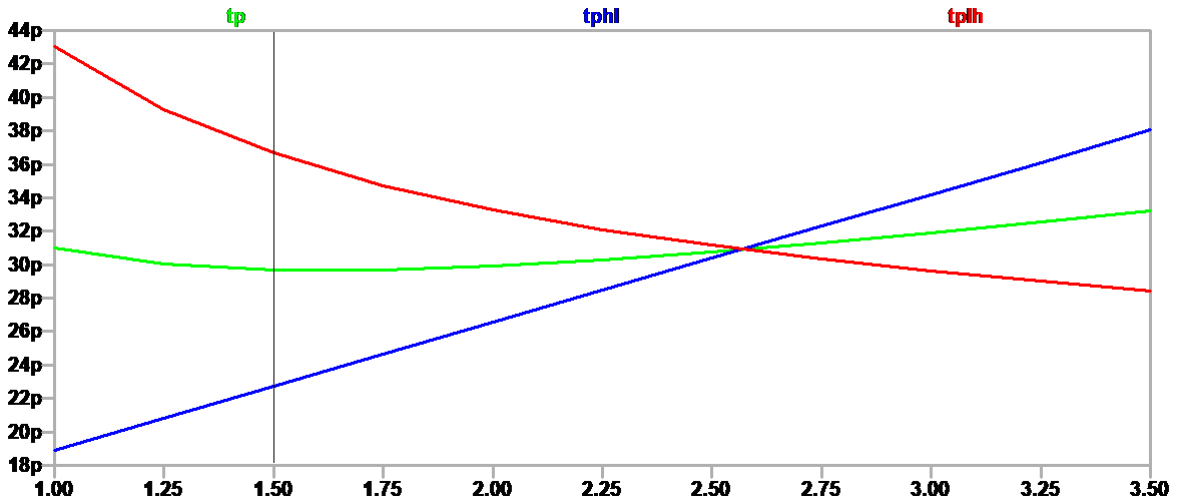
[picture p58: figure]

Figura 4: Simulación para encontrar el mejor ratio entre WN Y WP

## 4. Compuertas básicos

Implementé varias compuertas básicas y realicé simulaciones para verificar su comportamiento. Los componentes que diseñe son:

Inversor con el drain conectado a VDD y el source conectado a tierra.
Inversor con el drain y el source exportado en el netlist.
AND con 2 y 4 entradas.
NAND con 2, 3 y 4 entradas.
NOR con 2 entradas.
OR con 2 entradas.
XNOR con 2 entradas.
Transmission Gate.
MUX con 2 vias.
MUX con 4 vias y salida invertido.
FFD con reset asincróno.

Cada compuerta consiste de un .asc y un .asy, y es parametrizado, así que cada instancia puede usar tamaños diferentes. Figura 5 muestra una selección de las compuertas.

6


Figura 5: Una selección de compuertas.

## 5. VCO

Hay varias formas construir un VCO (por Voltage Controlled Oscillator), elegí usar un oscilador en anillo limitado por corriente. Figura 6 muestra la idea. Funciona cómo un oscilador en anillo normal pero los fuentes de corrientes controlan el tiempo de propagación del inversor, cambiando la frecuencia de operación.

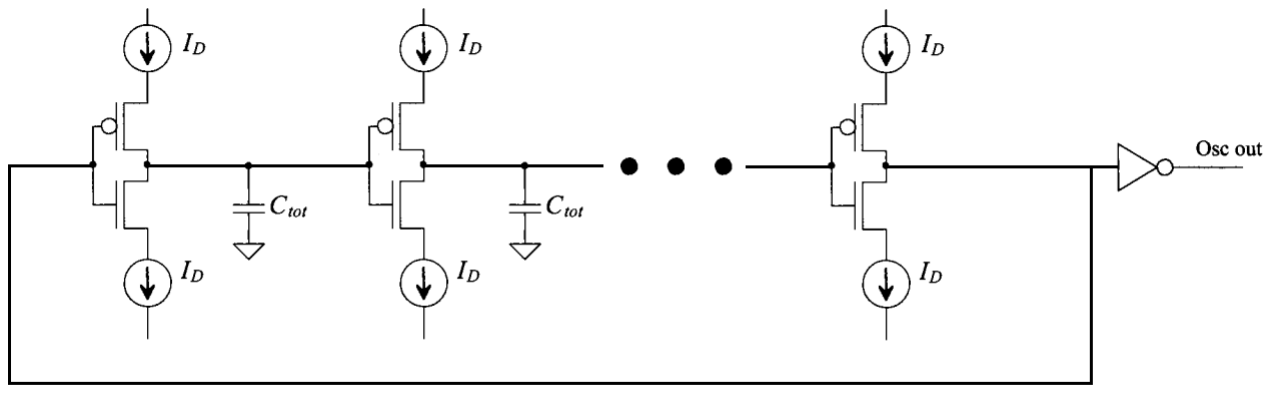
[picture p59: figure]

Figura 6: Un Oscilador en Anillo limitado por corriente.

7

Ctot =

5
2

C0OX(WN LN + WP LP )

f =

ID

NCtotVDD

Donde N es el número de inversores en el anillo, y WN , LN , WP , LP son los anchos y largos de los transistores en los inversores. Elegí una corriente central de 10 µA que me da por inversores mínimos, y N = 7:

Ctot = 4.0 fF
f = 198.4 MHz

El primer parte consistío en diseñar una fuente de corriente controlado por tensión. La figura 7 muestra el diseño utilizado.


Figura 7: Fuente de corriente controlado por tensión.

El resistor R1 controla la pendiente de corriente contra tensión de VIN y permite mejorar la linealidad de esta transferencia. El resistor R2 controla el corriente mínimo cuándo VIN < VT . Luego, simulando y aplicando un método iterativo se hallaron los siguientes valores:

WM1 = 4.0 µm | WM2 = 6.0 µm | WM1R = 12.0 µm | WM2R = 18.0 µm
L = 0.9 µm | R1 = 20.0 kΩ | R2 = 86.0 kΩ

Que me da la salida verde mostrada en figura 8. Una corriente mínima de 5.0 µA, una corriente central de 9.9 µA, y una corriente máxima de 20.4 µA. La pendiente es aproximadamente lineal para VIN > 0.7 V, cómo muestra la línea verde oscura, con una ecuación de ID = VIN · 11.8 µA/V − 0.8 µA. La salida roja es por el fuente de corriente con R2 = ∞Ω, tiene aproximadamente la misma pendiente de la salida con R2 = 86 kΩ, pero tiene ID ≈ 0 µA para VIN < 0.4 V.

8

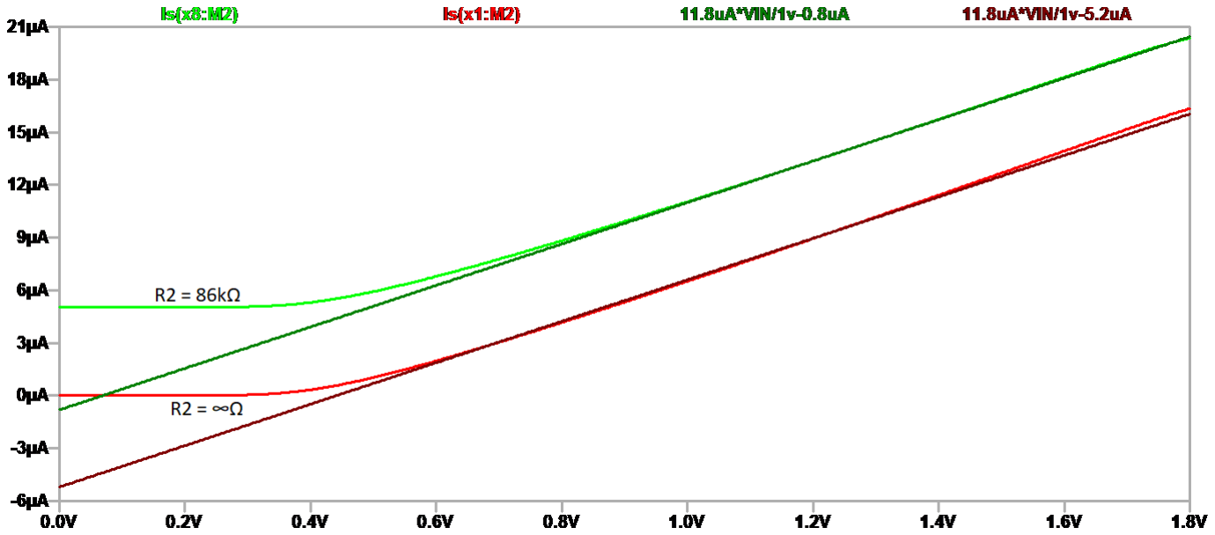
[picture p60: figure]

Figura 8: Simulación de la fuente de corriente controlado por tensión.

Figura 9 muestra el esquemático del VCO, y Figura 10 muestra el esquemático de prueba con todos los parámetros. Usa directivos de SPICE para medir y calcular la frecuencia promedio y el duty cycle sobre 100 ciclos. También calcula la frecuencia de salida esperada usando las ecuaciones anteriores. Encontré que la práctica y la teoría son diferentes para inversores mínimos, así realicé otras simulaciones para ver cómo cambiando WN afecta estos valores. Figura 11 muestra el resultado. La frecuencia calculada y medida están iguales por WN = 0.52 µm y VIN = 0.9 V. Luego, simulando frecuencia contra VIN usando valores de WN cerca de 0.52 µm encontré que la pendiente es el más lineal para WN = 0.57 µm, así usé eso valor en mi diseño final.


Figura 9: Esquemático del VCO.

9


Figura 10: Esquemático de la prueba para VCO.

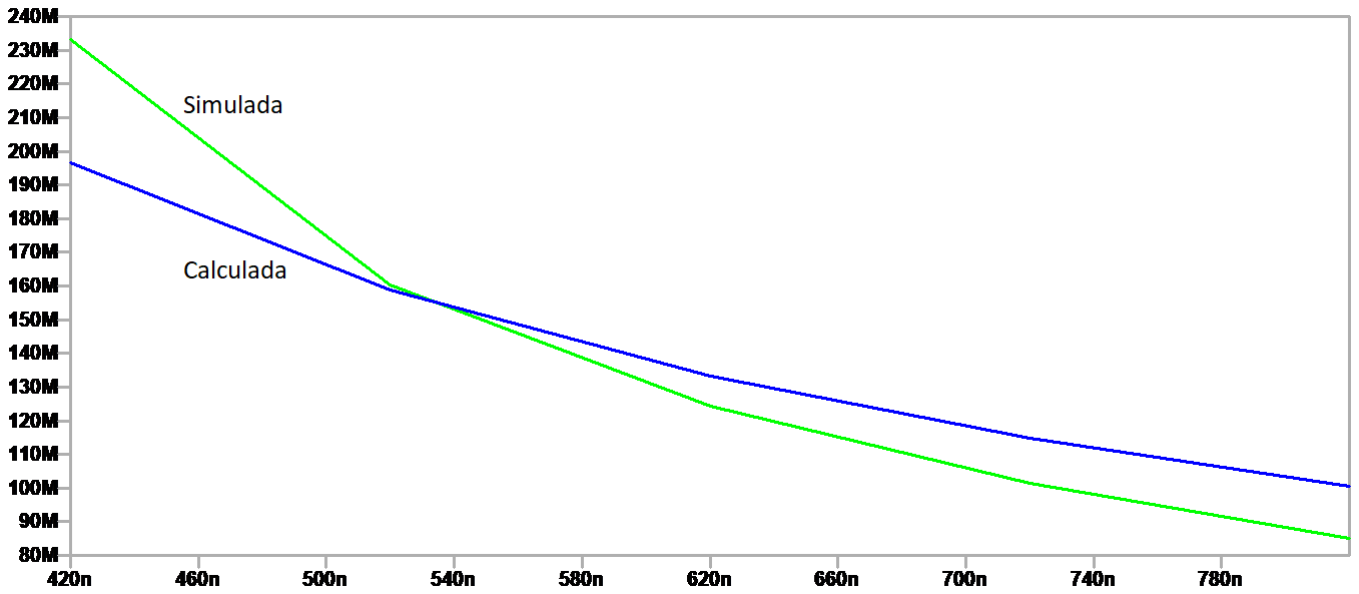
[picture p61: figure]

Figura 11: Simulación de Frecuencia medida y estimada contra WN .

Figura 12 muestra cómo cambia la frecuencia simulada y calculada con VIN . La pendiente del parte lineal es aproximadamente 200 MHz/V dando un KV CO = 2π · 200 MHz/V = 1.26 × 10⁹
rad/(V s). Se observa que ambas son similares para VIN entre 0.4 V y 1.2 V

10

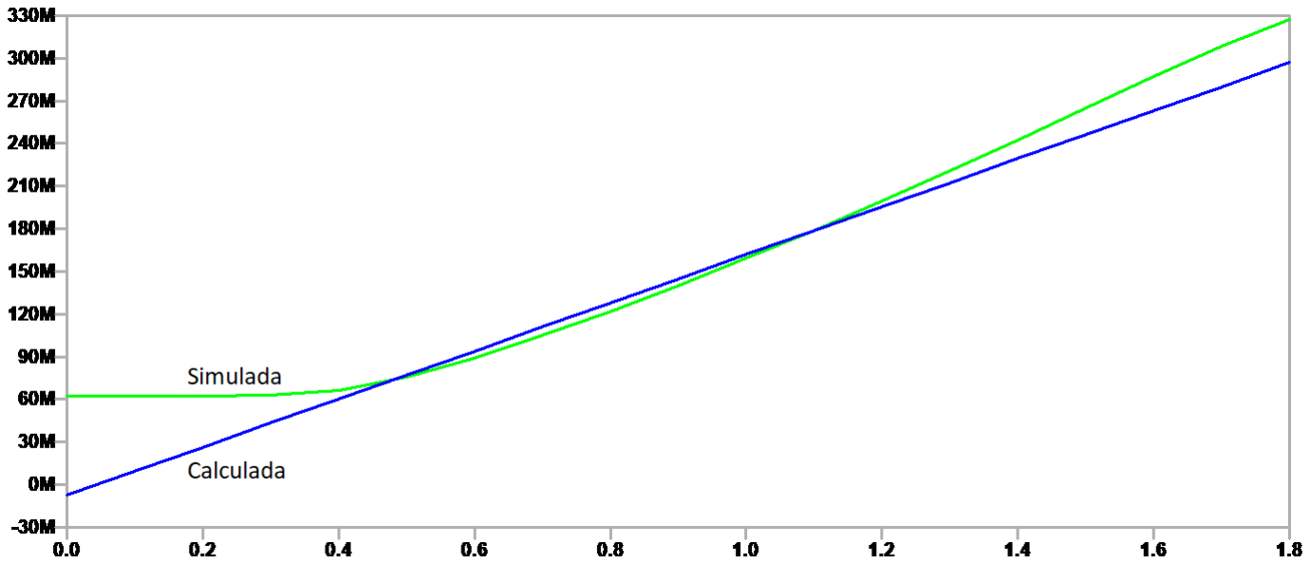
[picture p62: figure]

Figura 12: Simulación de Frecuencia medida y estimada contra VIN .

## 6. Divisor de Frecuencias

Hay varias arquitecturas para implementar divisores de frecuencias, cual es mejor depende en la especificación del proyecto. Para este trabajo quise dividir por un valor programable.
Al principio implemente un divisor de frecuencias que puede dividir por 2N . La implementación es N FFDs en cascada cómo muestra Figura 13. Cada ciclo del clkIn hace que div2 invierte su valor, así div2 completa un ciclo cada dos ciclos del clkIn. Después div4 completa un ciclo cada dos ciclos del div2, o cuatro ciclos del clkIn, etc... Mi implementación solo permite dividir hasta 2⁴ = 16, para dividir por factores más altos puede conectar dos de los componentes en cascada. Un MUX puede ser usado para elegir la salida querido, como muestra Figura 14.


Figura 13: Implementación de un divisor de frecuencias de 2N

La desventaja de esta arquitectura es que cuando se usa en un PLLD, solo se permite obtener una o dos frecuencias válidas. Por ejemplo con el VCO descripto en la sección anterior, la salida del VCO tiene que ser entre 60 MHz y 330 MHz. Por un reloj de entrada de 12 MHz solo se puede sintetizar una salida de 96 MHz usando un divisor de 8, o de 192 MHz usando un divisor de 16. Un divisor de 4 da una salida de 48 MHz y un divisor de 32 da una salida de 384 MHz, ambos de los dos están afuera del rango de la operación del VCO.

11


Figura 14: Prueba para el divisor de frecuencias de 2N

En este proyecto estoy intentando diseñar un PLLD por un micro, que puede ser utilizado en un rango de entornos grandes, así un divisor que puede producir un rango lineal de salidas será mejor. Así implementé un componente que divide por 2N. Figura 15 muestra una implementación. De nuevo usa una cadena de FFDs, pero este vez se usa como un contador digital. Unas compuertas XNOR hacen una comparación entre el valor del contador Q y el factor de división querido P. Cuando todos los bits están iguales invierte el clkOut. También implementé un otro divisor, mostrado en Figura 16, que es muy parecido. La única diferencia es el diseño del comparador. Figura 17 muestra una simulación comparando los dos. El primer diseño (con las compuertas XNOR) es aproximadamente 270 ps más rápido que el segundo, así elegí usar eso. Los dos diseños no funcionan cuando P = 0 y dan una salida con frecuencia fout = fin/2P por los demás valores de P.


Figura 15: Divisor de frecuencias de 2N.

12


Figura 16: Divisor de frecuencias de 2N con otro comparrador.

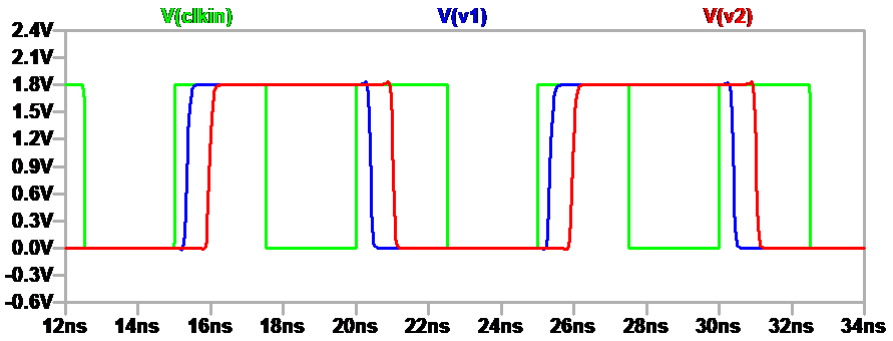
[picture p63: figure]

Figura 17: Comparación entre los dos divisores de 2N.

Con este divisor de frecuencias, el VCO de la sección anterior y un reloj de entrada de 12 MHz, podríamos producir 11 salidas con frecuencias entre 72 MHz y 312 MHz, lo que es mucho mejor que las dos frecuencias posibles con el divisor de 2N .

## 7. PFD y el Filtro de Lazo

El PFD (por Phase Frequency Detector) es un componente que toma dos señales y indique la diferencia entre sus fases. Figura 18 muestra una implementación de un PFD. En el primer flanco ascendente de dClock o clkIn la salida de su FFD cambia a un uno. Cuando llega el flanco de la otra señal, la salida de su FFD cambia a un uno también, así la salida de la compuerta AND cambia a un uno y pone a cero los dos FFDs. Así la salida UP o DOWN es alto por el tiempo entre los flancos ascendentes de los relojes. Estas dos señales pueden ser juntadas para

13 indicar la diferencia en fase. Usando directivas de SPICE simulé el tiempo que las señales UP y DOWN estuvieron alto por cada offset entre los relojes entre −800 ps y 800 ps en intervales de 10 ps, figura 19 muestra los resultados.


Figura 18: Un PFD básico.

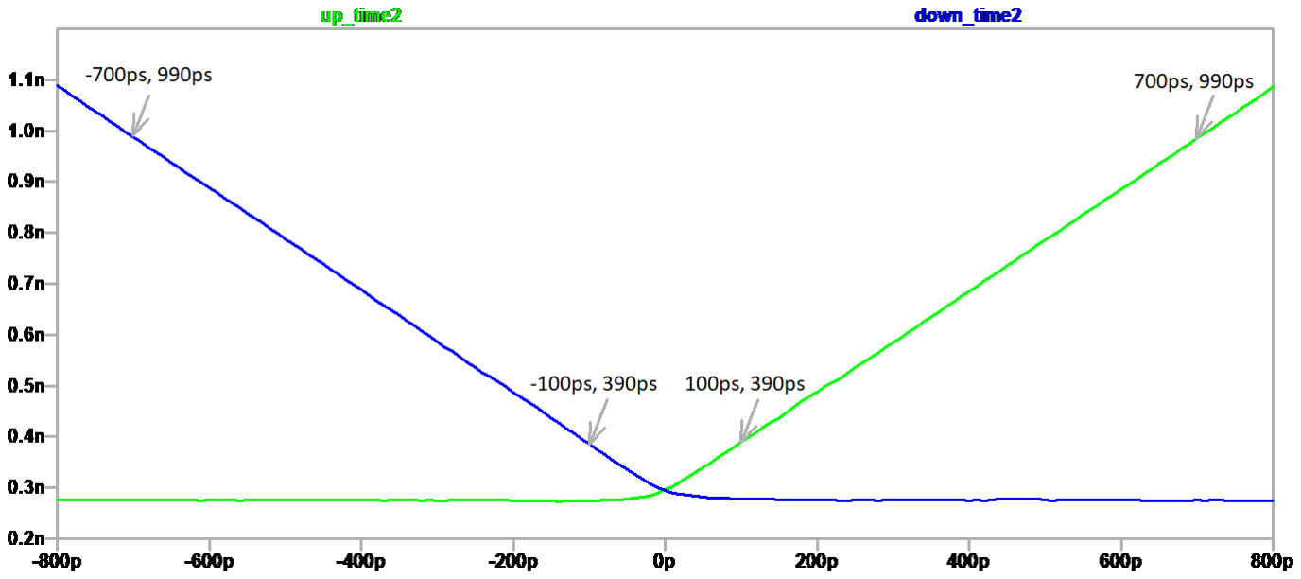
[picture p64: figure]

Figura 19: Simulación del PFD básico.

Figura 20 muestra otro diseño de un PFD, y Figura 21 muestra el ancho de los señales UP y DOWN. En este diseño hay un pequeño “dead zone” cuándo ninguno de los señales UP y DOWN están altos, pero en el diseño básico hay una superposición de aproximadamente 280 ps cuándo los dos señales están altos al mismo tiempo.

14

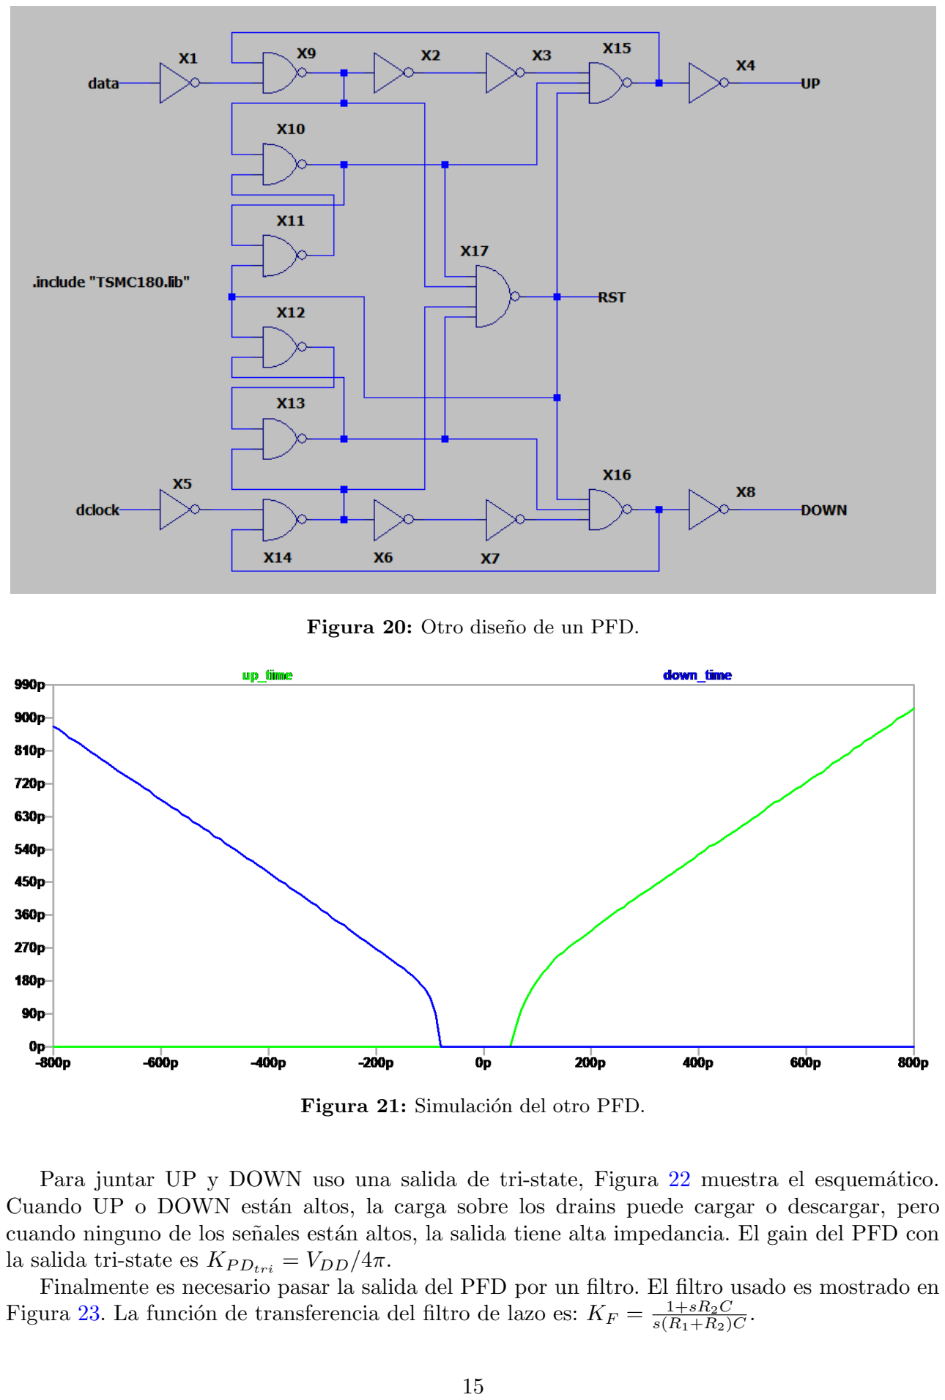
[picture p65: page 15]

Figura 20: Otro diseño de un PFD.

Figura 21: Simulación del otro PFD.

Para juntar UP y DOWN uso una salida de tri-state, Figura 22 muestra el esquemático. Cuando UP o DOWN están altos, la carga sobre los drains puede cargar o descargar, pero cuando ninguno de los señales están altos, la salida tiene alta impedancia. El gain del PFD con la salida tri-state es KPDtri = VDD/4π.
Finalmente es necesario pasar la salida del PFD por un filtro. El filtro usado es mostrado en Figura 23. La función de transferencia del filtro de lazo es: KF =

1+sR2C
s(R1+R2)C

15


Figura 22: Salida de tri-state.


Figura 23: Filtro de Lazo para usar con el PFD con salida tri-state.

16

## 8. PLLD

Figura 24 muestra el esquemático final del PLLD con todos los componentes conectados.


Figura 24: Esquemático del PLLD entero.

Las ecuaciones para este PLL son:

H(s) = | KPDtriKF KV CO s +
| 1 N KPDtriKF KV CO

ωn =

s
| KPDtriKV CO N(R1 + R2)C

ζ =

ωn
2
| R2C

∆ωL = 4πζωn

∆ωP =

π
2

p
| 2ζωnKV COKPDtri − ω²
n

Donde:

H(s) = La función de transferencia de fase. ωn = La frecuencia natural.
ζ = El factor de amortiguamiento.
∆ωL = El rango de lock.
N = El factor de división.
∆ωP = El rango de pull-in.

Comenzando con ζ = 1, ∆ωL = 20 MHz · 2π y N = 8. Encontramos ωn = 10 × 10⁶ rad/s y
R2C = 200 ns. Eligiendo C = 10 pF y R2 = 20 kΩ, podríamos encontrar R1 = 2.56 kΩ. Porque queremos tener N programable podríamos volver calcular ωn, ζ, ∆ωL, y ωP por cada N entre 2 y 30.

17

N | ωn (rad/s) | FN (MHz) | ζ | ωL (rad/s) | FL (MHz) | ωP (rad/s) | FP (MHz)
2 4 6 8 10 12 14 16 18 20 22 24 26 28 30 | 20.00 × 10⁶ 14.14 × 10⁶ 11.55 × 10⁶ 10.00 × 10⁶ 8.94 × 10⁶ 8.16 × 10⁶ 7.56 × 10⁶ 7.07 × 10⁶ 6.67 × 10⁶ 6.32 × 10⁶ 6.03 × 10⁶ 5.77 × 10⁶ 5.55 × 10⁶ 5.35 × 10⁶ 5.16 × 10⁶ | 3.18 2.25 1.84 1.59 1.42 1.30 1.20 1.13 1.06 1.01 0.96 0.92 0.88 0.85 0.82 | 2.0 1.4 1.2 1.0 0.9 0.8 0.8 0.7 0.7 0.6 0.6 0.6 0.6 0.5 0.5 | 503 × 10⁶ 251 × 10⁶ 168 × 10⁶ 126 × 10⁶ 101 × 10⁶ 84 × 10⁶ 72 × 10⁶ 63 × 10⁶ 56 × 10⁶ 50 × 10⁶ 46 × 10⁶ 42 × 10⁶ 39 × 10⁶ 36 × 10⁶ 34 × 10⁶ | 80 40 27 20 16 13 11 10 9 8 7 7 6 6 5 | 521 × 10⁶ 401 × 10⁶ 321 × 10⁶ 270 × 10⁶ 235 × 10⁶ 209 × 10⁶ 189 × 10⁶ 173 × 10⁶ 160 × 10⁶ 149 × 10⁶ 139 × 10⁶ 131 × 10⁶ 124 × 10⁶ 118 × 10⁶ 112 × 10⁶ | 83 64 51 43 37 33 30 27 25 24 22 21 20 19 18

Tabla 1. Dinámica del sistema para diferentes valores de N

Las Figuras 25, 26, 27 y 28 muestran varias simulaciones del PLLD entero con diferentes frecuencias de entrada entre 5 MHz y 100 MHz y diferentes valores de N entre 2 y 30. VIN es la entrada del VCO, y en todos los casos el sistema se enciende a t = 0 µs.

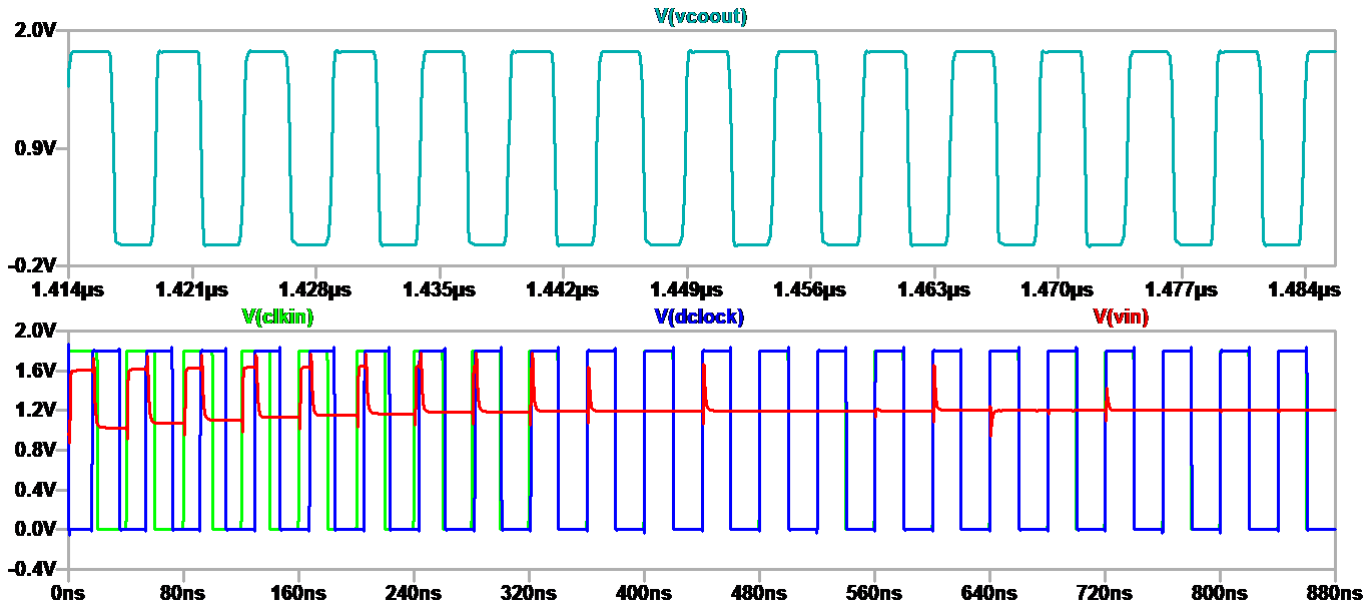
[picture p66: figure]

Figura 25: Simulación de un PLLD con reloj de entrada de 25 MHz, N=8 y salida 200 MHz.

18

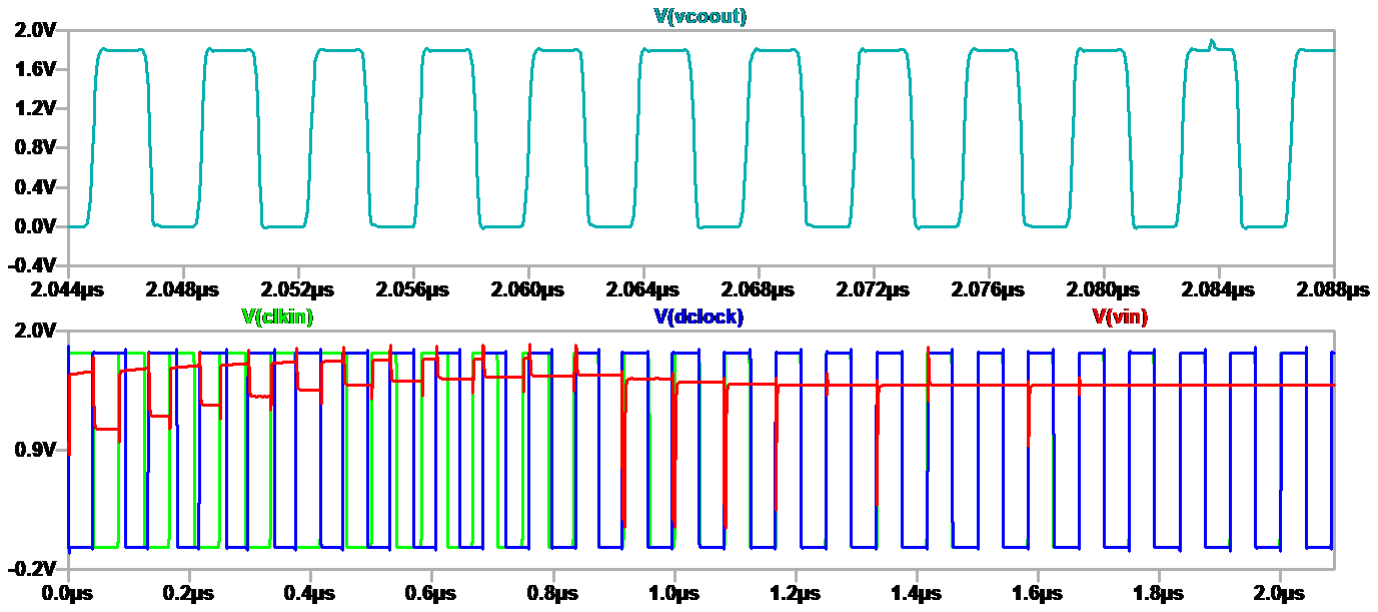
[picture p67: figure]

Figura 26: Simulación de un PLLD con reloj de entrada de 12 MHz, N=22 y salida 264 MHz.

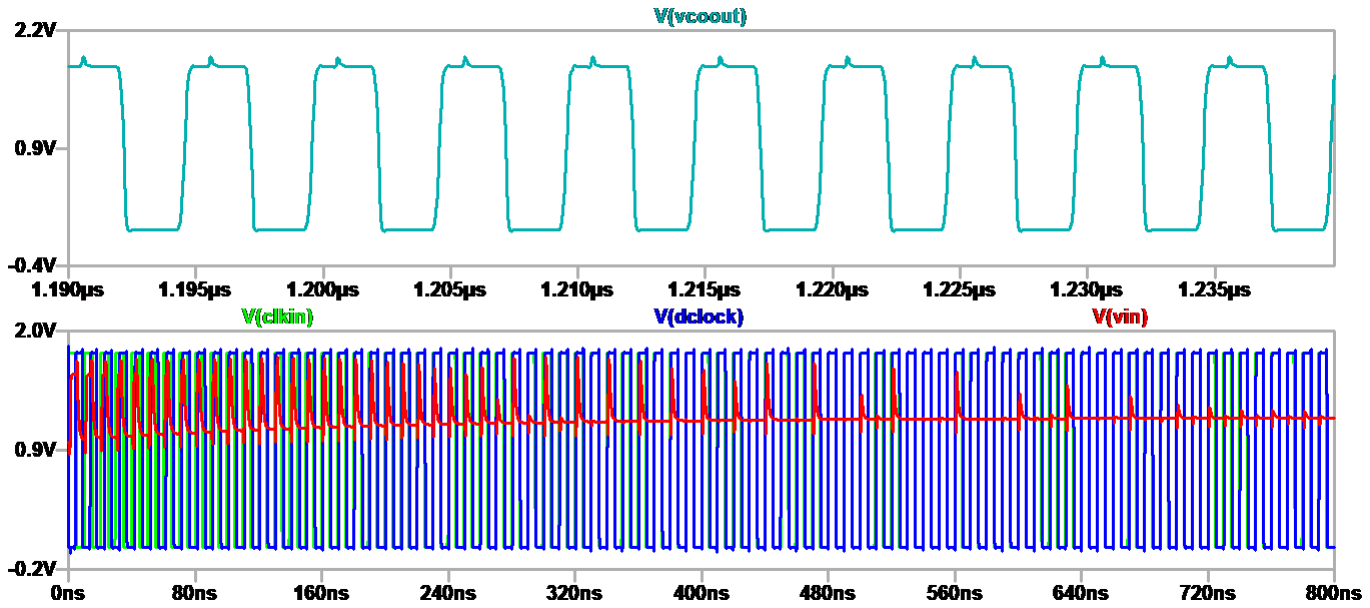
[picture p68: figure]

Figura 27: Simulación de un PLLD con reloj de entrada de 100 MHz, N=2 y salida 200 MHz.

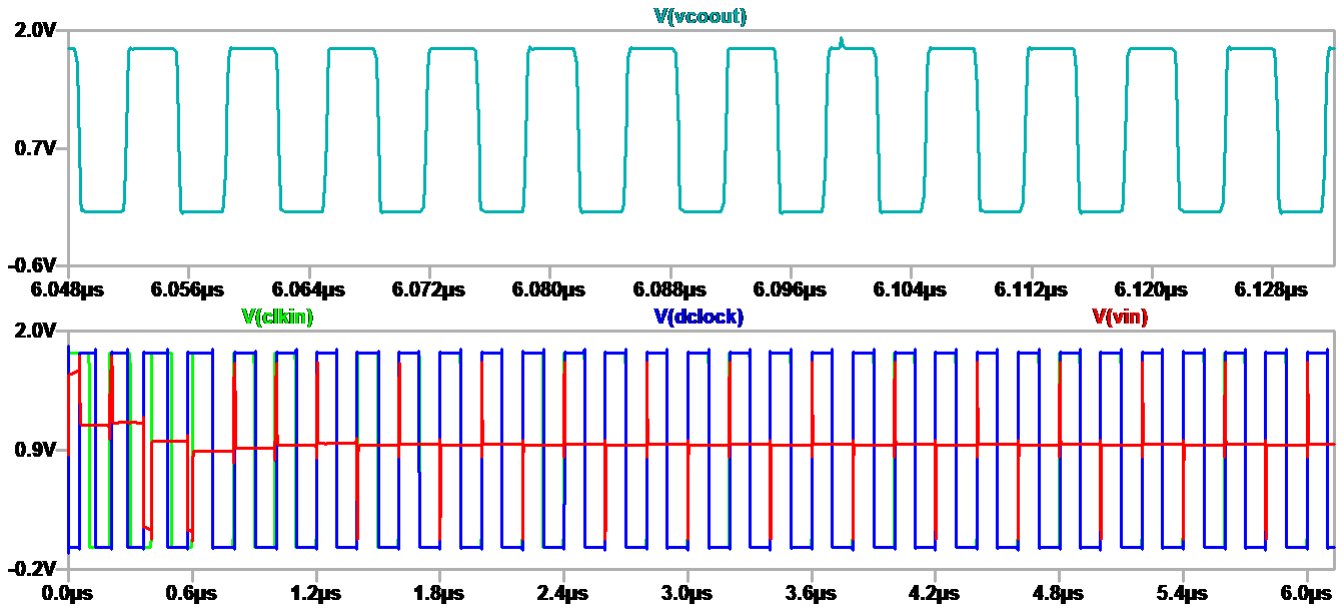
[picture p69: figure]

Figura 28: Simulación de un PLLD con reloj de entrada de 5 MHz, N=30 y salida 150 MHz.

## 9. Sintetizador de Frecuencias

El PLLD mostrado el la última sección tiene unas restricciones. La salida está limitado por el rango de operación del VCO lo que es 60 MHz a 330 MHz, y también la salida tiene que ser 2N · fref . Por ejemplo la única salida posibles para un reloj de entrada de 100 MHz es 200 MHz. Un sintetizador de frecuencias típicamente tiene un divisor antes y después del PLLD. Ese

19 se permite obtener más frecuencias desde la misma reloj de referencia. Figura 1 muestra un diagrama en bloques de un sintetizador de frecuencias. La salida ahora puede ser nfref
2pm para
n, m, p ∈ Z, siempre y cuando nfref
p

es en el rango de operación del VCO. En el caso de una entrada de 100 MHz se puede sintetizar muchas más frecuencias que antes. Por ejemplo:
p | n | fpll | m | ff s
2 | 6 | 300 MHz | 1 | 300 MHz
6 | 16 | 266.67 MHz | 6 | 44.44 MHz
10 | 8 | 80 MHz | 10 | 8 MHz


Figura 29: Esquemático de un sintetizador de frecuencias.

Figura 29 muestra el esquemático de un sintetizador de frecuencias, y la figura 30 muestra una simulación del sintetizador de frecuencias para obtener un reloj de 44.44 MHz desde un reloj de entrada de 100 MHz, con una frecuencia intermedio de 266.67 MHz, usando un prescalar de /6, un PLL de *16, y un postscalar de /6.

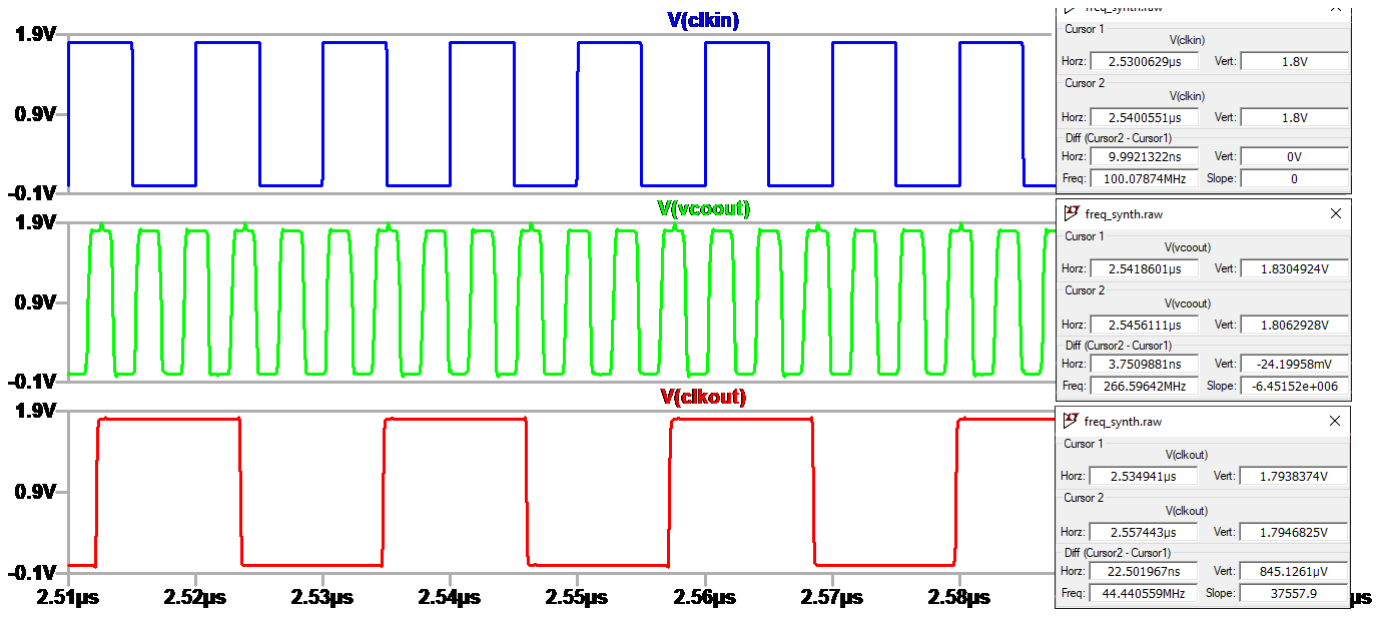
[picture p70: figure]

Figura 30: Simulación de un sintetizador de frecuencias con reloj de entrada de 100 MHz y salida 44.44 MHz.

20

## 10. Conclusión

En este proyecto, implementé y simulé un sintetizador de frecuencias que puede generar un reloj con un rango de frecuencias amplio, configurable por tres parámetros digitales: El prescalar “p”, el factor de multiplicación del PLLD “n” y el postscalar “m”. La frecuencia de la salida es especificado por:

fpll =

nfref
p

fo =

fpll
m

=

nfref
pm
60 MHz < fpll < 330 MHz
n, m, p ∈ Z y múltiples de 2 2 ≤ n, m, p ≤ 30

La salida máxima del sintetizador de frecuencias es 165 MHz, pero con un pequeño cambio para permitir bypass el postscalar, la frecuencia de salida máxima será 330 MHz. En la propuesta especifica una frecuencia máxima de 1 GHz, no pude lograr esto por las limitaciones de mi implementación del VCO. Un proyecto para el futuro puede ser mejorar el VCO para permitir obtener frecuencias más altas.
Otra proyecto para el futuro será la implementación de un banco de capacitores y resistores en el filtro de lazo, configurable por el parámetro n. Esto se permite mejorar la dinámica del sistema.

21

## Referencias

[1] R. Jacob Baker (2010) CMOS: Circuit design, layout and simulation, Wiley-IEEE Press, 3rd edition.
[2] Suman, Shruti & G Sharma, K & Ghosh, Pradip. (2016). Analysis and Design of Current Starved Ring VCO. 10.1109/ICEEOT.2016.7755299.
[3] Rushabh Mehta (2016) Ddesign and Implementation of a phase locked loop for high-speed serial links. University of Illinois. http://emlab.uiuc.edu/jose/Theses/mehta_ms.pdf.
[4] Passive Filters. http://aries.ucsd.edu/najmabadi/CLASS/ECE60L/02-S/NOTES/filter. pdf. (http://aries.ucsd.edu/najmabadi/CLASS/ECE60L/02-S/NOTES/filter.pdf)

22
