andrewparlane/fiuba6661_microelectronica_tpfinal/propuesta/images/freq_synth.png

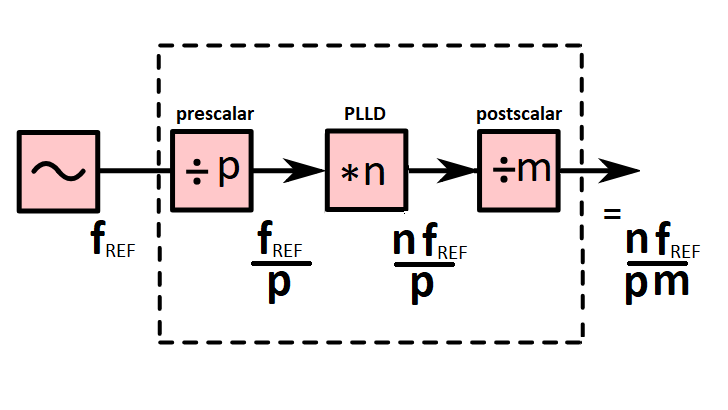
propuesta/images/freq_synth.png
