andrewparlane/fiuba6661_microelectronica_tpfinal/propuesta/images/plld.png

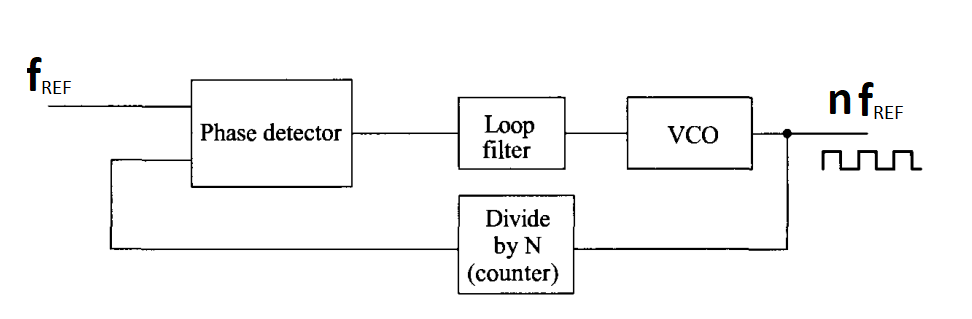
propuesta/images/plld.png
