andrewparlane/fiuba6661_microelectronica_tpfinal/sim/freq_divider_2n_test.asc

V1: voltage; PULSE(0 1.8 0 10p 10p {1/(2*FREQ)} {1/FREQ})
V2: voltage; PULSE(0 1.8 0 10p 10p 1n 2n 1)
VDD: voltage; 1.8
X1: freq_divider_2n_v2
X2: freq_divider_2n
Named nets: 0, clkIn, RST, VDD, V2, V1, P0, P1, P2, P3
.include "TSMC180.lib"
.tran 0 500n 0 100p
.param FREQ 200e6
