andrewparlane/fiuba6661_microelectronica_tpfinal/sim/freq_divider_power_2_test.asc

V1: voltage; PULSE(0 1.8 0 10p 10p 500p 1n)
V2: voltage; 1.8
X1: freq_divider_power_2
X2: inverting_mux_4
Named nets: 0, P1, P0, VDD, clkOut
.include "TSMC180.lib"
.tran 0 1u 0 100p
