andrewparlane/fiuba6661_microelectronica_tpfinal/sim/pfd_test.asc

V1: voltage; PULSE(1.8 0 {(1/(2*FREQ)) + TOFF} 70p 70p {1/(2*FREQ)} {1/FREQ} 3)
V2: voltage; PULSE(1.8 0 {1/(2*FREQ)} 70p 70p {1/(2*FREQ)} {1/FREQ} 3)
V3: voltage; PULSE(1.8 0 {(1/(2*FREQ)) + TOFF} 70p 70p {1/(2*FREQ)} {1/FREQ} 3)
V4: voltage; PULSE(1.8 0 {1/(2*FREQ)} 70p 70p {1/(2*FREQ)} {1/FREQ} 3)
X1: pfd2
X2: pfd
Named nets: 0, UP, DOWN, data, dclock, UP2, DOWN2, data2, dclock2
.param FREQ = 25e6
.tran 120n
.step param TOFF -800p 800p 10p
.meas TRAN UP_TIME TRIG V(UP)=0.9 RISE=1 TARG V(UP)=0.9 FALL=1
.meas TRAN DOWN_TIME TRIG V(DOWN)=0.9 RISE=1 TARG V(DOWN)=0.9 FALL=2
.meas TRAN DIFF PARAM UP_TIME - DOWN_TIME
.meas TRAN UP_TIME2 TRIG V(UP2)=0.9 RISE=1 TARG V(UP2)=0.9 FALL=1
.meas TRAN DOWN_TIME2 TRIG V(DOWN2)=0.9 RISE=1 TARG V(DOWN2)=0.9 FALL=1
.meas TRAN DIFF2 PARAM UP_TIME2 - DOWN_TIME2
