andrewparlane/fiuba6661_microelectronica_tpfinal/sim/vco7_test.asc

VIN: voltage; {VIN}
X1: vco7; VDD=1.8, LD={LD}, L_INV={L_INV}, WN_INV={WN_INV}, WPFACT_INV={WPFACT_INV}, L_CS={L_CS}, WN_CS={WN_CS}, WPFACT_CS={WPFACT_CS}, WIDE_FACT_CS={WIDE_FACT_CS}, R1_CS={R1_CS}, R2_CS={R2_CS}
Named nets: 0, clkOut
.param COX_PER_M_SQUARED = 8.418m
.param Ctot = { 2.5 * COX_PER_M_SQUARED * L_INV * (WN_INV + WP_INV) }
.param ID_CALC = {11.5u*VIN - 0.5u}
.param N = 7
.param FREQ_CALC = { ID_CALC / (N * Ctot * 1.8) }
.meas F_CALC_MEAS PARAM FREQ_CALC
.meas PERIOD_100 TRIG V(clkOut)=0.9 TD={DBS} RISE=1 TARG V(clkOut)=0.9 TD={DBS} RISE=101
.meas FREQ PARAM 100/(PERIOD_100)
.param DBS = 5u
.meas DUTY_CYCLE AVG 100*V(clkOut)/1.8 TRIG V(clkOut)=0.9 TD={DBS} TARG V(clkOut)=0.9 TD={DBS} RISE=101
.tran 0 8u 0 100p
.step param VIN 0 1.8 0.1
Cacular la frecuencia esperado por cada VIN
Nota: solo válido para CS con:
    L_CS = 0.9u
    WN_CS = 4u
    WPFACT_CS = 1.5
    R1_CS = 20k
    R2_CS = 86k
    WIDE_FACT = 3
Medir la frecuencia y el duty cycle de la salida
.param LD = 0.48u
.param L_INV = 0.18u
.param WN_INV = 0.57u
.param WPFACT_INV = 1.5
.param L_CS = 0.9u
.param WN_CS = 4u
.param WPFACT_CS = 1.5
.param WIDE_FACT_CS = 3
.param R1_CS = 20k
.param R2_CS =86k
.param WP_INV = {WN_INV * WPFACT_INV}
DBS -> DELAY BEFORE SAMPLE
