andrewparlane/fiuba6661_microelectronica_tpfinal/sim/vco_current_souurce_test.asc

M1: pmos4; CMOSP; l={L_CS} w={WP_CS} ad={ADS(WP_CS, LD)} as={ADS(WP_CS, LD)} pd={PDS(WP_CS, LD)} ps={PDS(WP_CS, LD)}
M2: pmos4; CMOSP; l={L_CS} w={WP_CS} ad={ADS(WP_CS, LD)} as={ADS(WP_CS, LD)} pd={PDS(WP_CS, LD)} ps={PDS(WP_CS, LD)}
M3: nmos4; CMOSN; l={L_CS} w={WN_CS} ad={ADS(WN_CS, LD)} as={ADS(WN_CS, LD)} pd={PDS(WN_CS, LD)} ps={PDS(WN_CS, LD)}
M4: pmos4; CMOSP; l={L_CS} w={WP_CS} ad={ADS(WP_CS, LD)} as={ADS(WP_CS, LD)} pd={PDS(WP_CS, LD)} ps={PDS(WP_CS, LD)}
M5: nmos4; CMOSN; l={L_CS} w={WN_CS} ad={ADS(WN_CS, LD)} as={ADS(WN_CS, LD)} pd={PDS(WN_CS, LD)} ps={PDS(WN_CS, LD)}
M6: nmos4; CMOSN; l={L_CS} w={WN_CS} ad={ADS(WN_CS, LD)} as={ADS(WN_CS, LD)} pd={PDS(WN_CS, LD)} ps={PDS(WN_CS, LD)}
V1: voltage; 1.8
V2: voltage; PULSE(0 1.8 500p {TR} {TF} 5n 10n)
V3: voltage; PULSE(0 1.8 500p {TR} {TF} 5n 10n)
Vin: voltage; {VIN}
X1: inversor4; VDD=1.8 L={L_INV} LD={LD} WN={WN_INV} WPFACT=1.5
X2: inversor4; VDD=1.8 L={L_INV} LD={LD} WN={WN_INV} WPFACT=1.5
X3: inversor
X4: inversor
X8: vco_current_source; VDD=1.8 L={L_CS} W_BASE={WN_CS} WPFACT={WPFACT_CS} WIDE_FACT={WIDE_FACT} LD=0.48u R1={R1_CS} R2={R2_CS}
Named nets: 0, Vdd, VIN, VP, VN, IN_NORMAL, OUT_CS, OUT_NORMAL, IN_CS
.include "TSMC180.lib"
.func ADS(w, ld) = {w * ld}
.func PDS(w, ld) {w + 2*ld}
.param LD = 0.48u
.param L_CS = 0.9u
.param WN_CS 4u
.param VIN 0
.param WPFACT_CS 1.5
.param WP_CS = { WN_CS * WPFACT_CS }
.param L_INV = 0.9u
.param WN_INV = 2.1u
.meas TRAN tphl_cs TRIG V(IN_CS)=V(Vdd)/2 TD=0 RISE=1 TARG V(OUT_CS)=V(Vdd)/2 FALL=1
.meas TRAN tplh_cs TRIG V(IN_CS)=V(Vdd)/2 TD=0 FALL=1 TARG V(OUT_CS)=V(Vdd)/2 RISE=1
.meas TRAN tp_cs PARAM (tphl_cs + tplh_cs)/2
.meas TRAN tr_out_cs TRIG V(OUT_CS)=V(Vdd)*0.1 TD=0 RISE=1 TARG V(OUT_CS)=V(Vdd)*0.9 RISE=1
.meas TRAN tf_out_cs TRIG V(OUT_CS)=V(Vdd)*0.9 TD=0 FALL=1 TARG V(OUT_CS)=V(Vdd)*0.1 FALL=1
.meas TRAN tphl_normal TRIG V(IN_NORMAL)=V(Vdd)/2 TD=0 RISE=1 TARG V(OUT_NORMAL)=V(Vdd)/2 FALL=1
.meas TRAN tplh_normal TRIG V(IN_NORMAL)=V(Vdd)/2 TD=0 FALL=1 TARG V(OUT_NORMAL)=V(Vdd)/2 RISE=1
.meas TRAN tp_normal PARAM (tphl_normal + tplh_normal)/2
.meas TRAN tr_out_normal TRIG V(OUT_NORMAL)=V(Vdd)*0.1 TD=0 RISE=1 TARG V(OUT_NORMAL)=V(Vdd)*0.9 RISE=1
.meas TRAN tf_out_normal TRIG V(OUT_NORMAL)=V(Vdd)*0.9 TD=0 FALL=1 TARG V(OUT_NORMAL)=V(Vdd)*0.1 FALL=1
.param R1_CS 20k
.param WIDE_FACT = 3
.param TR = 73p
.param TF = 37p
.dc Vin 0 1.8 1m
.param R2_CS 86k
