andrewparlane/fiuba6661_microelectronica_tpfinal/sim/vco_current_souurce_test2.asc

M2: pmos4; CMOSP; l={L_CS} w={WP_CS} ad={ADS(WP_CS, LD)} as={ADS(WP_CS, LD)} pd={PDS(WP_CS, LD)} ps={PDS(WP_CS, LD)}
M6: nmos4; CMOSN; l={L_CS} w={WN_CS} ad={ADS(WN_CS, LD)} as={ADS(WN_CS, LD)} pd={PDS(WN_CS, LD)} ps={PDS(WN_CS, LD)}
V1: voltage; 1.8
Vin: voltage; PULSE(0 1.8 0 50n 50n)
X8: vco_current_source; VDD=1.8 L={L_CS} W_BASE={WN_CS} WPFACT={WPFACT_CS} WIDE_FACT={WIDE_FACT} LD=0.48u R1={R1_CS} R2={R2_CS}
Named nets: 0, Vdd, VIN, VP, VN
.include "TSMC180.lib"
.func ADS(w, ld) = {w * ld}
.func PDS(w, ld) {w + 2*ld}
.param LD = 0.48u
.dc Vin 0 1.8 1m
.param L_CS 0.9u
.param WN_CS 4u
.param WPFACT_CS 1.5
.param WP_CS = { WN_CS * WPFACT_CS }
.param L_INV = 0.9u
.param WN_INV = 2.1u
.param R1_CS = 20k
.param WIDE_FACT = 3
.param R2_CS = 86k
