andrewparlane/fiuba6661_microelectronica_tpfinal/sim/xor_test.asc

V1: voltage; 1.8
V2: voltage; PULSE(0 1.8 400p 10p 10p 400p 800p 1)
V3: voltage; PULSE(0 1.8 200p 10p 10p 200p 400p 2)
X1: xor
X2: xor2
Named nets: 0, Vdd, A, B, OUT, OUT2
.include "TSMC180.lib"
.tran 1n
