andrewparlane/fiuba6661_microelectronica_tpfinal/sim/freq_divider_2n.asc

X1: ffd_arst; VDD={VDD} L={L} LD={LD} WN={WN} WPFACT=1.5
X2: ffd_arst; VDD={VDD} L={L} LD={LD} WN={WN} WPFACT=1.5
X3: ffd_arst; VDD={VDD} L={L} LD={LD} WN={WN} WPFACT=1.5
X4: ffd_arst; VDD={VDD} L={L} LD={LD} WN={WN} WPFACT=1.5
X5: and; VDD={VDD} L={L} LD={LD} WN={WN} WPFACT={WPFACT}
X6: and; VDD={VDD} L={L} LD={LD} WN={WN} WPFACT={WPFACT}
X7: ffd_arst; VDD={VDD} L={L} LD={LD} WN={WN} WPFACT=1.5
X8: xnor; VDD={VDD} L_INV={L} LD={LD} WN_INV={WN} WPFACT={WPFACT} L_TG={L} W_TG={WN}
X9: xnor; VDD={VDD} L_INV={L} LD={LD} WN_INV={WN} WPFACT={WPFACT} L_TG={L} W_TG={WN}
X10: xnor; VDD={VDD} L_INV={L} LD={LD} WN_INV={WN} WPFACT={WPFACT} L_TG={L} W_TG={WN}
X11: xnor; VDD={VDD} L_INV={L} LD={LD} WN_INV={WN} WPFACT={WPFACT} L_TG={L} W_TG={WN}
X15: and; VDD={VDD} L={L} LD={LD} WN={WN} WPFACT={WPFACT}
X17: or
Named nets: clkIn, Q0, Q1, Q2, Q3, P0, P1, P2, P3, rst_internal, RST, clkOut
.include "TSMC180.lib"
