andrewparlane/fiuba6661_microelectronica_tpfinal/sim/freq_divider_2n_v2.asc

X1: ffd_arst; VDD={VDD} L={L} LD={LD} WN={WN} WPFACT=1.5
X2: ffd_arst; VDD={VDD} L={L} LD={LD} WN={WN} WPFACT=1.5
X3: ffd_arst; VDD={VDD} L={L} LD={LD} WN={WN} WPFACT=1.5
X4: ffd_arst; VDD={VDD} L={L} LD={LD} WN={WN} WPFACT=1.5
X5: or; VDD={VDD} L={L} LD={LD} WN={WN} WPFACT=1.5
X6: and4; VDD={VDD} L={L} LD={LD} WN={WN} WPFACT=1.5
X7: mux2; VDD={VDD} L={L} LD={LD} WN={WN} WPFACT=1.5
X8: inversor; VDD={VDD} L={L} LD={LD} WN={WN} WPFACT=1.5
X9: mux2; VDD={VDD} L={L} LD={LD} WN={WN} WPFACT=1.5
X10: inversor; VDD={VDD} L={L} LD={LD} WN={WN} WPFACT=1.5
X11: mux2; VDD={VDD} L={L} LD={LD} WN={WN} WPFACT=1.5
X12: inversor; VDD={VDD} L={L} LD={LD} WN={WN} WPFACT=1.5
X13: mux2; VDD={VDD} L={L} LD={LD} WN={WN} WPFACT=1.5
X14: inversor; VDD={VDD} L={L} LD={LD} WN={WN} WPFACT=1.5
X16: ffd_arst; VDD={VDD} L={L} LD={LD} WN={WN} WPFACT=1.5
Named nets: clkIn, Q0, Q1, Q2, Q3, RST, P0, P1, P2, P3, clkOut
.include "TSMC180.lib"
