andrewparlane/fiuba6661_microelectronica_tpfinal/sim/freq_synth.asc

V1: voltage; 1.8
V2: voltage; PULSE(0 1.8 0 10p 10p 1n 2n 1)
V3: voltage; PULSE(0 1.8 0 10p 10p {1/(2*FREQ)} {1/FREQ})
X1: vco7; VDD=1.8, LD={LD}, L_INV={VCO_L_INV}, WN_INV={VCO_WN_INV}, WPFACT_INV={WPFACT}, L_CS={VCO_L_CS}, WN_CS={VCO_WN_CS}, WPFACT_CS={WPFACT}, WIDE_FACT_CS={VCO_WIDE_FACT_CS}, R1_CS={VCO_R1_CS}, R2_CS={VCO_R2_CS}
X2: pfd_and_tri_state; VDD=1.8 LD={LD} PFD_L={PFD_L} PFD_WN={PFD_WN} TS_L={PFD_TS_L} TS_WN={PFD_TS_WN} WPFACT={WPFACT}
X3: pfd_loop_filter; R1={F_R1} R2={F_R2} C={F_C}
X4: freq_divider_2n; VDD=1.8 L={FD_L} LD={LD} WN={FD_WN} WPFACT={WPFACT}
X5: freq_divider_2n; VDD=1.8 L={FD_L} LD={LD} WN={FD_WN} WPFACT={WPFACT}
X11: freq_divider_2n; VDD=1.8 L={FD_L} LD={LD} WN={FD_WN} WPFACT={WPFACT}
Named nets: 0, Vdd, Vpd, VIN, RST, clkIn, dclock, clkOut, vcoOut, VDD
.include "TSMC180.lib"
.param LD = 0.48u
.tran 0 10u 0 100p
.param FREQ = 100e6
.param WPFACT = 1.5
PFD
Filtro de Lazo
VCO
Divisor de frecuencias
.param F_R1 = 2.56k
.param F_R2 = 20k
.param F_C = 10p
.param VCO_L_INV = 0.18u
.param VCO_WN_INV = 0.57u
.param VCO_L_CS = 0.9u
.param VCO_WN_CS = 4u
.param VCO_WIDE_FACT_CS = 3
.param VCO_R1_CS = 20k
.param VCO_R2_CS =86k
.param PFD_L = 0.18u
.param PFD_WN = 0.42u
.param PFD_TS_L = 0.9u
.param PFD_TS_WN = 2.1u
.param FD_L = 0.18u
.param FD_WN = 0.42u
Prescaler /2
Postscaler /2
