andrewparlane/fiuba6661_microelectronica_tpfinal/sim/mux2.asc

V1: voltage; {VDD}
X1: inversor; VDD={VDD} L={L} LD={LD} WN={WN} WPFACT={WPFACT}
X2: tgate; VDD={VDD} L={L} LD={LD} W={WN}
X3: tgate; VDD={VDD} L={L} LD={LD} W={WN}
X4: inversor; VDD={VDD} L={L} LD={LD} WN={WN} WPFACT={WPFACT}
X5: inversor; VDD={VDD} L={L} LD={LD} WN={WN} WPFACT={WPFACT}
Named nets: 0, Vdd, O, S, nS, A, B, x
