andrewparlane/fiuba6661_microelectronica_tpfinal/sim/pfd.asc

V1: voltage; {VDD}
X1: ffd_arst; VDD={VDD} L={L} LD={LD} WN={WN} WPFACT=1.5
X2: ffd_arst; VDD={VDD} L={L} LD={LD} WN={WN} WPFACT=1.5
X3: and; VDD={VDD} L={L} LD={LD} WN={WN} WPFACT=1.5
Named nets: Vdd, clkIn, dClock, UP, DOWN, 0
.include "TSMC180.lib"
