andrewparlane/fiuba6661_microelectronica_tpfinal/sim/pfd2.asc

X1: inversor; VDD={VDD} L={L} LD={LD} WN={WN} WPFACT={WPFACT}
X2: inversor; VDD={VDD} L={L} LD={LD} WN={WN} WPFACT={WPFACT}
X3: inversor; VDD={VDD} L={L} LD={LD} WN={WN} WPFACT={WPFACT}
X4: inversor; VDD={VDD} L={L} LD={LD} WN={WN} WPFACT={WPFACT}
X5: inversor; VDD={VDD} L={L} LD={LD} WN={WN} WPFACT={WPFACT}
X6: inversor; VDD={VDD} L={L} LD={LD} WN={WN} WPFACT={WPFACT}
X7: inversor; VDD={VDD} L={L} LD={LD} WN={WN} WPFACT={WPFACT}
X8: inversor; VDD={VDD} L={L} LD={LD} WN={WN} WPFACT={WPFACT}
X9: nand; VDD={VDD} L={L} LD={LD} WN={WN} WPFACT={WPFACT}
X10: nand; VDD={VDD} L={L} LD={LD} WN={WN} WPFACT={WPFACT}
X11: nand; VDD={VDD} L={L} LD={LD} WN={WN} WPFACT={WPFACT}
X12: nand; VDD={VDD} L={L} LD={LD} WN={WN} WPFACT={WPFACT}
X13: nand; VDD={VDD} L={L} LD={LD} WN={WN} WPFACT={WPFACT}
X14: nand; VDD={VDD} L={L} LD={LD} WN={WN} WPFACT={WPFACT}
X15: nand3; VDD={VDD} L={L} LD={LD} WN={WN} WPFACT={WPFACT}
X16: nand3; VDD={VDD} L={L} LD={LD} WN={WN} WPFACT={WPFACT}
X17: nand4; VDD={VDD} L={L} LD={LD} WN={WN} WPFACT={WPFACT}
Named nets: data, dclock, RST, UP, DOWN
.include "TSMC180.lib"
