andrewparlane/fiuba6661_microelectronica_tpfinal/sim/pfd_and_tri_state.asc

X8: pfd2; VDD={VDD} L={PFD_L} LD={LD} WN={PFD_WN} WPFACT={WPFACT}
X9: pfd_tri_state; VDD={VDD} L={TS_L} LD={LD} WN={TS_WN} WPFACT={WPFACT}
Named nets: data, dclock, Vpd
.include "TSMC180.lib"
