andrewparlane/fiuba6661_microelectronica_tpfinal/sim/pfd_loop_filter.asc

C1: cap; {C}
R1: res; {R1}
R2: res; {R2}
Named nets: Vpd, 0, VIN
