andrewparlane/fiuba6661_microelectronica_tpfinal/sim/pfd_tri_state.asc

M1: pmos4; CMOSP; l={L} w={WP} ad={ADS(WP, LD)} as={ADS(WP, LD)} pd={PDS(WP, LD)} ps={PDS(WP, LD)}
M2: nmos4; CMOSN; l={L} w={WN} ad={ADS(WN, LD)} as={ADS(WN, LD)} pd={PDS(WN, LD)} ps={PDS(WN, LD)}
V1: voltage; 1.8
X1: inversor; VDD={VDD} L={L} LD={LD} WN={WN} WPFACT={WPFACT}
Named nets: 0, Vdd, Vpd, UP, DOWN
.include "TSMC180.lib"
.func ADS(w, ld) = {w * ld}
.func PDS(w, ld) {w + 2*ld}
.param WP = {WN * WPFACT}
