andrewparlane/fiuba6661_microelectronica_tpfinal/sim/xnor.asc

V1: voltage; {VDD}
X1: inversor; VDD={VDD} L={L_INV} LD={LD} WN={WN_INV} WPFACT={WPFACT}
X2: inversor; VDD={VDD} L={L_INV} LD={LD} WN={WN_INV} WPFACT={WPFACT}
X3: tgate; VDD={VDD} L={L_TG} LD={LD} W={W_TG}
X4: tgate; VDD={VDD} L={L_TG} LD={LD} W={W_TG}
X5: inversor; VDD={VDD} L={L_INV} LD={LD} WN={WN_INV} WPFACT={WPFACT}
Named nets: 0, Vdd, OUT, A, nA, B, x, nB
