andrewparlane/fiuba6661_microelectronica_tpfinal/sim/vco7.asc

M3: pmos4; CMOSP; l={L_CS} w={WP_CS} ad={ADS(WP_CS, LD)} as={ADS(WP_CS, LD)} pd={PDS(WP_CS, LD)} ps={PDS(WP_CS, LD)}
M4: nmos4; CMOSN; l={L_CS} w={WN_CS} ad={ADS(WN_CS, LD)} as={ADS(WN_CS, LD)} pd={PDS(WN_CS, LD)} ps={PDS(WN_CS, LD)}
M5: pmos4; CMOSP; l={L_CS} w={WP_CS} ad={ADS(WP_CS, LD)} as={ADS(WP_CS, LD)} pd={PDS(WP_CS, LD)} ps={PDS(WP_CS, LD)}
M6: nmos4; CMOSN; l={L_CS} w={WN_CS} ad={ADS(WN_CS, LD)} as={ADS(WN_CS, LD)} pd={PDS(WN_CS, LD)} ps={PDS(WN_CS, LD)}
M7: pmos4; CMOSP; l={L_CS} w={WP_CS} ad={ADS(WP_CS, LD)} as={ADS(WP_CS, LD)} pd={PDS(WP_CS, LD)} ps={PDS(WP_CS, LD)}
M8: nmos4; CMOSN; l={L_CS} w={WN_CS} ad={ADS(WN_CS, LD)} as={ADS(WN_CS, LD)} pd={PDS(WN_CS, LD)} ps={PDS(WN_CS, LD)}
M9: pmos4; CMOSP; l={L_CS} w={WP_CS} ad={ADS(WP_CS, LD)} as={ADS(WP_CS, LD)} pd={PDS(WP_CS, LD)} ps={PDS(WP_CS, LD)}
M10: nmos4; CMOSN; l={L_CS} w={WN_CS} ad={ADS(WN_CS, LD)} as={ADS(WN_CS, LD)} pd={PDS(WN_CS, LD)} ps={PDS(WN_CS, LD)}
M11: pmos4; CMOSP; l={L_CS} w={WP_CS} ad={ADS(WP_CS, LD)} as={ADS(WP_CS, LD)} pd={PDS(WP_CS, LD)} ps={PDS(WP_CS, LD)}
M12: nmos4; CMOSN; l={L_CS} w={WN_CS} ad={ADS(WN_CS, LD)} as={ADS(WN_CS, LD)} pd={PDS(WN_CS, LD)} ps={PDS(WN_CS, LD)}
M13: pmos4; CMOSP; l={L_CS} w={WP_CS} ad={ADS(WP_CS, LD)} as={ADS(WP_CS, LD)} pd={PDS(WP_CS, LD)} ps={PDS(WP_CS, LD)}
M14: nmos4; CMOSN; l={L_CS} w={WN_CS} ad={ADS(WN_CS, LD)} as={ADS(WN_CS, LD)} pd={PDS(WN_CS, LD)} ps={PDS(WN_CS, LD)}
M15: pmos4; CMOSP; l={L_CS} w={WP_CS} ad={ADS(WP_CS, LD)} as={ADS(WP_CS, LD)} pd={PDS(WP_CS, LD)} ps={PDS(WP_CS, LD)}
M16: nmos4; CMOSN; l={L_CS} w={WN_CS} ad={ADS(WN_CS, LD)} as={ADS(WN_CS, LD)} pd={PDS(WN_CS, LD)} ps={PDS(WN_CS, LD)}
V1: voltage; {VDD}
X0: vco_current_source; VDD=1.8 L={L_CS} W_BASE={WN_CS} WPFACT=1.5 WIDE_FACT={WIDE_FACT_CS} LD=0.48u R1={R1_CS} R2={R2_CS}
X1: inversor4; VDD=1.8 L={L_INV} LD={LD} WN={WN_INV} WPFACT=1.5
X2: inversor4; VDD=1.8 L={L_INV} LD={LD} WN={WN_INV} WPFACT=1.5
X3: inversor4; VDD=1.8 L={L_INV} LD={LD} WN={WN_INV} WPFACT=1.5
X4: inversor4; VDD=1.8 L={L_INV} LD={LD} WN={WN_INV} WPFACT=1.5
X5: inversor4; VDD=1.8 L={L_INV} LD={LD} WN={WN_INV} WPFACT=1.5
X6: inversor4; VDD=1.8 L={L_INV} LD={LD} WN={WN_INV} WPFACT=1.5
X7: inversor4; VDD=1.8 L={L_INV} LD={LD} WN={WN_INV} WPFACT=1.5
XOUT1: inversor
XOUT2: inversor
Named nets: 0, Vdd, VIN, VN, VP, clkOut
.include "TSMC180.lib"
.func ADS(w, ld) = {w * ld}
.func PDS(w, ld) {w + 2*ld}
.param WP_CS = { WN_CS * WPFACT_CS }
.param WP_INV = { WN_INV * WPFACT_INV }
