andrewparlane/fiuba6661_microelectronica_tpfinal/sim/pfd_plld.asc

C1: cap; 10p
M1: pmos4; CMOSP; l={L_FILTER} w={WP_FILTER} ad={ADS(WP_FILTER, LD)} as={ADS(WP_FILTER, LD)} pd={PDS(WP_FILTER, LD)} ps={PDS(WP_FILTER, LD)}
M2: nmos4; CMOSN; l={L_FILTER} w={WN_FILTER} ad={ADS(WN_FILTER, LD)} as={ADS(WN_FILTER, LD)} pd={PDS(WN_FILTER, LD)} ps={PDS(WN_FILTER, LD)}
M3: pmos4; CMOSP; l={L_CS} w={WP_CS} ad={ADS(WP_CS, LD)} as={ADS(WP_CS, LD)} pd={PDS(WP_CS, LD)} ps={PDS(WP_CS, LD)}
M4: nmos4; CMOSN; l={L_CS} w={WN_CS} ad={ADS(WN_CS, LD)} as={ADS(WN_CS, LD)} pd={PDS(WN_CS, LD)} ps={PDS(WN_CS, LD)}
M5: pmos4; CMOSP; l={L_CS} w={WP_CS} ad={ADS(WP_CS, LD)} as={ADS(WP_CS, LD)} pd={PDS(WP_CS, LD)} ps={PDS(WP_CS, LD)}
M6: nmos4; CMOSN; l={L_CS} w={WN_CS} ad={ADS(WN_CS, LD)} as={ADS(WN_CS, LD)} pd={PDS(WN_CS, LD)} ps={PDS(WN_CS, LD)}
M7: pmos4; CMOSP; l={L_CS} w={WP_CS} ad={ADS(WP_CS, LD)} as={ADS(WP_CS, LD)} pd={PDS(WP_CS, LD)} ps={PDS(WP_CS, LD)}
M8: nmos4; CMOSN; l={L_CS} w={WN_CS} ad={ADS(WN_CS, LD)} as={ADS(WN_CS, LD)} pd={PDS(WN_CS, LD)} ps={PDS(WN_CS, LD)}
M9: pmos4; CMOSP; l={L_CS} w={WP_CS} ad={ADS(WP_CS, LD)} as={ADS(WP_CS, LD)} pd={PDS(WP_CS, LD)} ps={PDS(WP_CS, LD)}
M10: nmos4; CMOSN; l={L_CS} w={WN_CS} ad={ADS(WN_CS, LD)} as={ADS(WN_CS, LD)} pd={PDS(WN_CS, LD)} ps={PDS(WN_CS, LD)}
M11: pmos4; CMOSP; l={L_CS} w={WP_CS} ad={ADS(WP_CS, LD)} as={ADS(WP_CS, LD)} pd={PDS(WP_CS, LD)} ps={PDS(WP_CS, LD)}
M12: nmos4; CMOSN; l={L_CS} w={WN_CS} ad={ADS(WN_CS, LD)} as={ADS(WN_CS, LD)} pd={PDS(WN_CS, LD)} ps={PDS(WN_CS, LD)}
M13: pmos4; CMOSP; l={L_CS} w={WP_CS} ad={ADS(WP_CS, LD)} as={ADS(WP_CS, LD)} pd={PDS(WP_CS, LD)} ps={PDS(WP_CS, LD)}
M14: nmos4; CMOSN; l={L_CS} w={WN_CS} ad={ADS(WN_CS, LD)} as={ADS(WN_CS, LD)} pd={PDS(WN_CS, LD)} ps={PDS(WN_CS, LD)}
M15: pmos4; CMOSP; l={L_CS} w={WP_CS} ad={ADS(WP_CS, LD)} as={ADS(WP_CS, LD)} pd={PDS(WP_CS, LD)} ps={PDS(WP_CS, LD)}
M16: nmos4; CMOSN; l={L_CS} w={WN_CS} ad={ADS(WN_CS, LD)} as={ADS(WN_CS, LD)} pd={PDS(WN_CS, LD)} ps={PDS(WN_CS, LD)}
R1: res; 2.56k
R2: res; 20k
V1: voltage; 1.8
V2: voltage; {VIN}
V3: voltage; PULSE(0 1.8 0 70p 70p 20n 40n)
V4: voltage; PULSE(0 1.8 0 70p 70p 1n 2n 1)
X0: vco_current_source; VDD=1.8 L={L_CS} W_BASE={WN_CS} WPFACT=1.5 WIDE_FACT={WIDE_FACT_CS} LD=0.48u R1={R1_CS} R2={R2_CS}
X1: inversor4; VDD=1.8 L={L_INV} LD={LD} WN={WN_INV} WPFACT=1.5
X2: inversor4; VDD=1.8 L={L_INV} LD={LD} WN={WN_INV} WPFACT=1.5
X3: inversor4; VDD=1.8 L={L_INV} LD={LD} WN={WN_INV} WPFACT=1.5
X4: inversor4; VDD=1.8 L={L_INV} LD={LD} WN={WN_INV} WPFACT=1.5
X5: inversor4; VDD=1.8 L={L_INV} LD={LD} WN={WN_INV} WPFACT=1.5
X6: inversor4; VDD=1.8 L={L_INV} LD={LD} WN={WN_INV} WPFACT=1.5
X7: inversor4; VDD=1.8 L={L_INV} LD={LD} WN={WN_INV} WPFACT=1.5
X8: pfd2
X10: inversor
X11: freq_divider_2n
XOUT1: inversor
XOUT2: inversor
Named nets: 0, Vdd, VIN, VP, VN, clkOut, Vpd, UP, DOWN, VDD, RST, inClk, dclock
.include "TSMC180.lib"
.func ADS(w, ld) = {w * ld}
.func PDS(w, ld) {w + 2*ld}
.param L_INV = 0.18u
.param LD = 0.48u
.tran 0 10u 0 100p
.param WN_INV 0.57u
.param L_CS = 0.9u
.param WN_CS = 4u
.param VIN 0
.param WPFACT_CS = 1.5
.param WIDE_FACT_CS = 3
.meas PERIOD TRIG V(clkOut)=0.9 TD={DELAY_BEFORE_SAMPLE} RISE=1 TARG V(clkOut)=0.9 TD={DELAY_BEFORE_SAMPLE} RISE=3
.meas FREQ PARAM 2/(PERIOD)
.meas TH TRIG V(clkOut)=1.7 RISE=300 TARG V(clkOut)=1.7 FALL=300
.meas TL TRIG V(clkOut)=0.1 FALL=300 TARG V(clkOut)=0.1 RISE=301
.meas DUTY_CYCLE_PERCENNT PARAM 100*TH/(TH+TL)
.param DELAY_BEFORE_SAMPLE 500n
.meas DUTY_CYCLE_2 INTEG 100*V(clkOut)/(1.8*200n) FROM 800n TO 1u
.param R1_CS 20k
.param WP_CS = { WN_CS * WPFACT_CS }
.param COX_PER_M_SQUARED = 8.418m
.param Ctot = { 2.5 * COX_PER_M_SQUARED * L_INV * (WN_INV + WP_INV) }
.param WPFACT_INV = 1.5
.param WP_INV = { WN_INV * WPFACT_INV }
.param ID_CALC = {11.5u*VIN - 0.5u}
.param N = 7
.param FREQ_CALC = { ID_CALC / (N * Ctot * 1.8) }
.meas F_CALC_MEAS PARAM FREQ_CALC
.param R2_CS 86k
.param WP_FILTER = {WN_FILTER * WPFACT_FILTER}
.param L_FILTER = 1.8u
.param WN_FILTER = 4.2u
.param WPFACT_FILTER = 1.5
