andrewparlane/fiuba6661_microelectronica_tpfinal/sim/and3.asc

X1: nand3; VDD={VDD} L={L} LD={LD} WN={WN} WPFACT={WPFACT}
X2: inversor; VDD={VDD} L={L} LD={LD} WN={WN} WPFACT={WPFACT}
Named nets: Out, A, C, B
.include "TSMC180.lib"
