andrewparlane/fiuba6661_microelectronica_tpfinal/sim/vco_current_source.asc

M1: nmos4; CMOSN; l={L} w={W_M1} ad={ADS(W_M1, LD)} as={ADS(W_M1, LD)} pd={PDS(W_M1, LD)} ps={PDS(W_M1, LD)}
M1R: nmos4; CMOSN; l={L} w={W_M1R} ad={ADS(W_M1R, LD)} as={ADS(W_M1R, LD)} pd={PDS(W_M1R, LD)} ps={PDS(W_M1R, LD)}
M2: pmos4; CMOSP; l={L} w={W_M2} ad={ADS(W_M2, LD)} as={ADS(W_M2, LD)} pd={PDS(W_M2, LD)} ps={PDS(W_M2, LD)}
M2R: pmos4; CMOSP; l={L} w={W_M2R} ad={ADS(W_M2R, LD)} as={ADS(W_M2R, LD)} pd={PDS(W_M2R, LD)} ps={PDS(W_M2R, LD)}
R1: res; {R1}
R2: res; {R2}
V1: voltage; {VDD}
Named nets: 0, Vdd, VIN, VOUT_P, VOUT_N
.include "TSMC180.lib"
.func ADS(w, ld) = {w * ld}
.func PDS(w, ld) {w + 2*ld}
.param W_M1R = { W_BASE * WIDE_FACT }
.param W_M2R = { W_BASE * WPFACT * WIDE_FACT }
.param W_M1 = {W_BASE}
.param W_M2 = { W_BASE * WPFACT }
