andrewparlane/fiuba6661_microelectronica_tpfinal/sim/ffd_arst.asc

X1: inversor; VDD={VDD} L={L} LD={LD} WN={WN} WPFACT={WPFACT}
X2: inversor; VDD={VDD} L={L} LD={LD} WN={WN} WPFACT={WPFACT}
X3: tgate; VDD={VDD} L={L} LD={LD} W={WN}
X4: tgate; VDD={VDD} L={L} LD={LD} W={WN}
X5: nor; VDD={VDD} L={L} LD={LD} WN={WN} WPFACT={WPFACT}
X6: inversor; VDD={VDD} L={L} LD={LD} WN={WN} WPFACT={WPFACT}
X7: inversor; VDD={VDD} L={L} LD={LD} WN={WN} WPFACT={WPFACT}
X8: tgate; VDD={VDD} L={L} LD={LD} W={WN}
X9: tgate; VDD={VDD} L={L} LD={LD} W={WN}
X10: nor; VDD={VDD} L={L} LD={LD} WN={WN} WPFACT={WPFACT}
X11: inversor; VDD={VDD} L={L} LD={LD} WN={WN} WPFACT={WPFACT}
X12: inversor; VDD={VDD} L={L} LD={LD} WN={WN} WPFACT={WPFACT}
Named nets: nCLK, CLK, D, Q, R, nQ
