andrewparlane/fiuba6661_microelectronica_tpfinal/sim/inverting_mux_4.asc

X1: inversor; VDD={VDD} L={L} LD={LD} WN={WN} WPFACT={WPFACT}
X2: inversor; VDD={VDD} L={L} LD={LD} WN={WN} WPFACT={WPFACT}
X3: tgate; VDD={VDD} L={L} LD={LD} W={WN}
X4: tgate; VDD={VDD} L={L} LD={LD} W={WN}
X5: tgate; VDD={VDD} L={L} LD={LD} W={WN}
X6: tgate; VDD={VDD} L={L} LD={LD} W={WN}
X7: tgate; VDD={VDD} L={L} LD={LD} W={WN}
X8: tgate; VDD={VDD} L={L} LD={LD} W={WN}
X9: tgate; VDD={VDD} L={L} LD={LD} W={WN}
X10: tgate; VDD={VDD} L={L} LD={LD} W={WN}
X11: inversor; VDD={VDD} L={L} LD={LD} WN={WN} WPFACT={WPFACT}
Named nets: S0, S1, nS0, nS1, nO, I0, I1, I2, I3
