andrewparlane/fiuba6661_microelectronica_tpfinal/sim/phase_detector_xor.asc

C1: cap; 10n
R1: res; 100k
V1: voltage; 1.8
V2: voltage; PULSE(0 1.8 0 10p 10p {1/(2*F_A)} {1/F_A})
V3: voltage; PULSE(0 1.8 0 10p 10p {1/(2*F_B)} {1/F_B})
X1: xor
Named nets: 0, Vdd, A, B, Out, x
.include "TSMC180.lib"
.param F_A 100e6
.param F_B 80e6
.tran 100n
