andrewparlane/fiuba6661_microelectronica_tpfinal/sim/tgate.asc

M1: nmos4; CMOSN; l={L} w={W} ad={ADS(W,LD)} as={ADS(W,LD)} pd={PDS(W,LD)} ps={PDS(W,LD)}
M2: pmos4; CMOSP; l={L} w={W} ad={ADS(W,LD)} as={ADS(W,LD)} pd={PDS(W,LD)} ps={PDS(W,LD)}
V2: voltage; {VDD}
Named nets: Vdd, 0, EN, nEN, B, A
.include "TSMC180.lib"
.func ADS(w, ld) = {w * ld}
.func PDS(w, ld) {w + 2*ld}
