andrewparlane/fiuba6661_microelectronica_tpfinal/sim/wpfact.asc

M1: pmos4; CMOSP; l={L} w={WP} ad={ADS(WP, LD)} as={ADS(WP, LD)} pd={PDS(WP, LD)} ps={PDS(WP, LD)}
M2: nmos4; CMOSN; l={L} w={WN} ad={ADS(WN, LD)} as={ADS(WN, LD)} pd={PDS(WN, LD)} ps={PDS(WN, LD)}
M3: pmos4; CMOSP; l={L} w={WP} ad={ADS(WP, LD)} as={ADS(WP, LD)} pd={PDS(WP, LD)} ps={PDS(WP, LD)}
M4: nmos4; CMOSN; l={L} w={WN} ad={ADS(WN, LD)} as={ADS(WN, LD)} pd={PDS(WN, LD)} ps={PDS(WN, LD)}
V1: voltage; 1.8
V2: voltage; PULSE(0 1.8 100p 10p 10p 100p 200p 1)
Named nets: 0, Vdd, V0, V1
.include "TSMC180.lib"
.func ADS(w, ld) = {w * ld}
.func PDS(w, ld) {w + 2*ld}
.param WP = {WN * WPFACT}
.param L = 0.18u
.param LD = 0.48u
.param WN = 0.42u
.tran 0 300p 0p 0.1p
.step param WPFACT 1 3.5 0.25
.meas TRAN tphl TRIG V(V0)=0.9 TD=0 RISE=1 TARG V(V1)=0.9 FALL=1
.meas TRAN tplh TRIG V(V0)=0.9 TD=0 FALL=1 TARG V(V1)=0.9 RISE=1
.meas TRAN tp PARAM (tphl + tplh)/2
