andrewparlane/fiuba6661_microelectronica_tpfinal/sim/xor2.asc

M1: nmos4; CMOSN; l={L} w={2*WN} ad={ADS(2*WN, LD)} as={ADS(2*WN, LD)} pd={PDS(2*WN, LD)} ps={PDS(2*WN, LD)}
M2: nmos4; CMOSN; l={L} w={2*WN} ad={ADS(2*WN, LD)} as={ADS(2*WN, LD)} pd={PDS(2*WN, LD)} ps={PDS(2*WN, LD)}
M3: pmos4; CMOSP; l={L} w={WP} ad={ADS(WP, LD)} as={ADS(WP, LD)} pd={PDS(WP, LD)} ps={PDS(WP, LD)}
M4: nmos4; CMOSN; l={L} w={2*WN} ad={ADS(2*WN, LD)} as={ADS(2*WN, LD)} pd={PDS(2*WN, LD)} ps={PDS(2*WN, LD)}
M5: nmos4; CMOSN; l={L} w={2*WN} ad={ADS(2*WN, LD)} as={ADS(2*WN, LD)} pd={PDS(2*WN, LD)} ps={PDS(2*WN, LD)}
M6: pmos4; CMOSP; l={L} w={WP} ad={ADS(WP, LD)} as={ADS(WP, LD)} pd={PDS(WP, LD)} ps={PDS(WP, LD)}
M7: pmos4; CMOSP; l={L} w={WP} ad={ADS(WP, LD)} as={ADS(WP, LD)} pd={PDS(WP, LD)} ps={PDS(WP, LD)}
M8: pmos4; CMOSP; l={L} w={WP} ad={ADS(WP, LD)} as={ADS(WP, LD)} pd={PDS(WP, LD)} ps={PDS(WP, LD)}
V1: voltage; {VDD}
X1: inversor; VDD={VDD} L={L} LD={LD} WN={WN} WPFACT={WPFACT}
X2: inversor; VDD={VDD} L={L} LD={LD} WN={WN} WPFACT={WPFACT}
Named nets: Vdd, 0, nA, nB, B, A, Out
.include "TSMC180.lib"
.func ADS(w, ld) = {w * ld}
.func PDS(w, ld) {w + 2*ld}
.param WP = {WN * WPFACT * 2}
