andrewparlane/fiuba6661_microelectronica_tpfinal/(commit log)

2019-03-10 All the current simulations / components.
2019-03-22 Updated the PFD PLL to use the divide by 2n component instead of the divide by power 2 component.
